alexb7396/Tesi_Magistrale/plots/A5256__Assembly.pdf

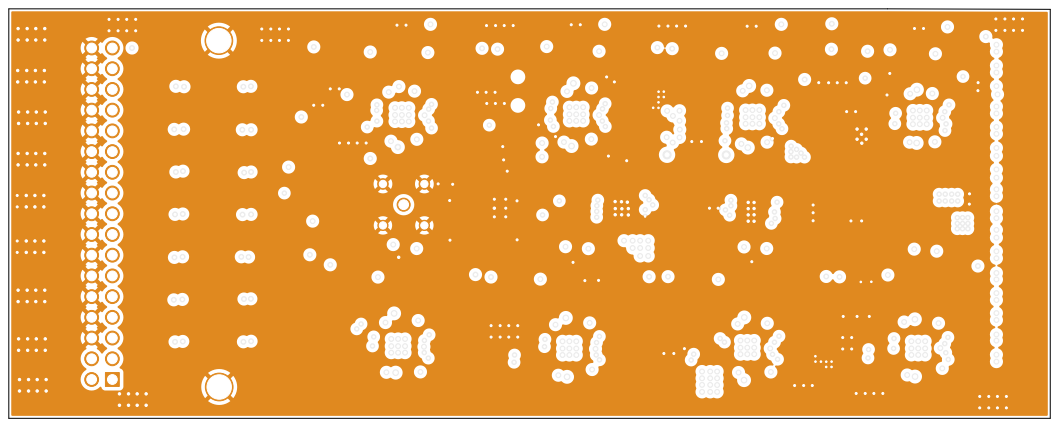
[picture p1: page 1]
D Date: KiCad; E.D.A. 8.0.7 Size: A4; Rev:; Board2Pdf:; GND -; Page

Id: 1/1 Title: File: A5256.kicad_pcb Sheet: GND
