alexb7396/Tesi_Magistrale/A5256.kicad_pcb

## KiCad design A5256.kicad_pcb (2024-12-22)

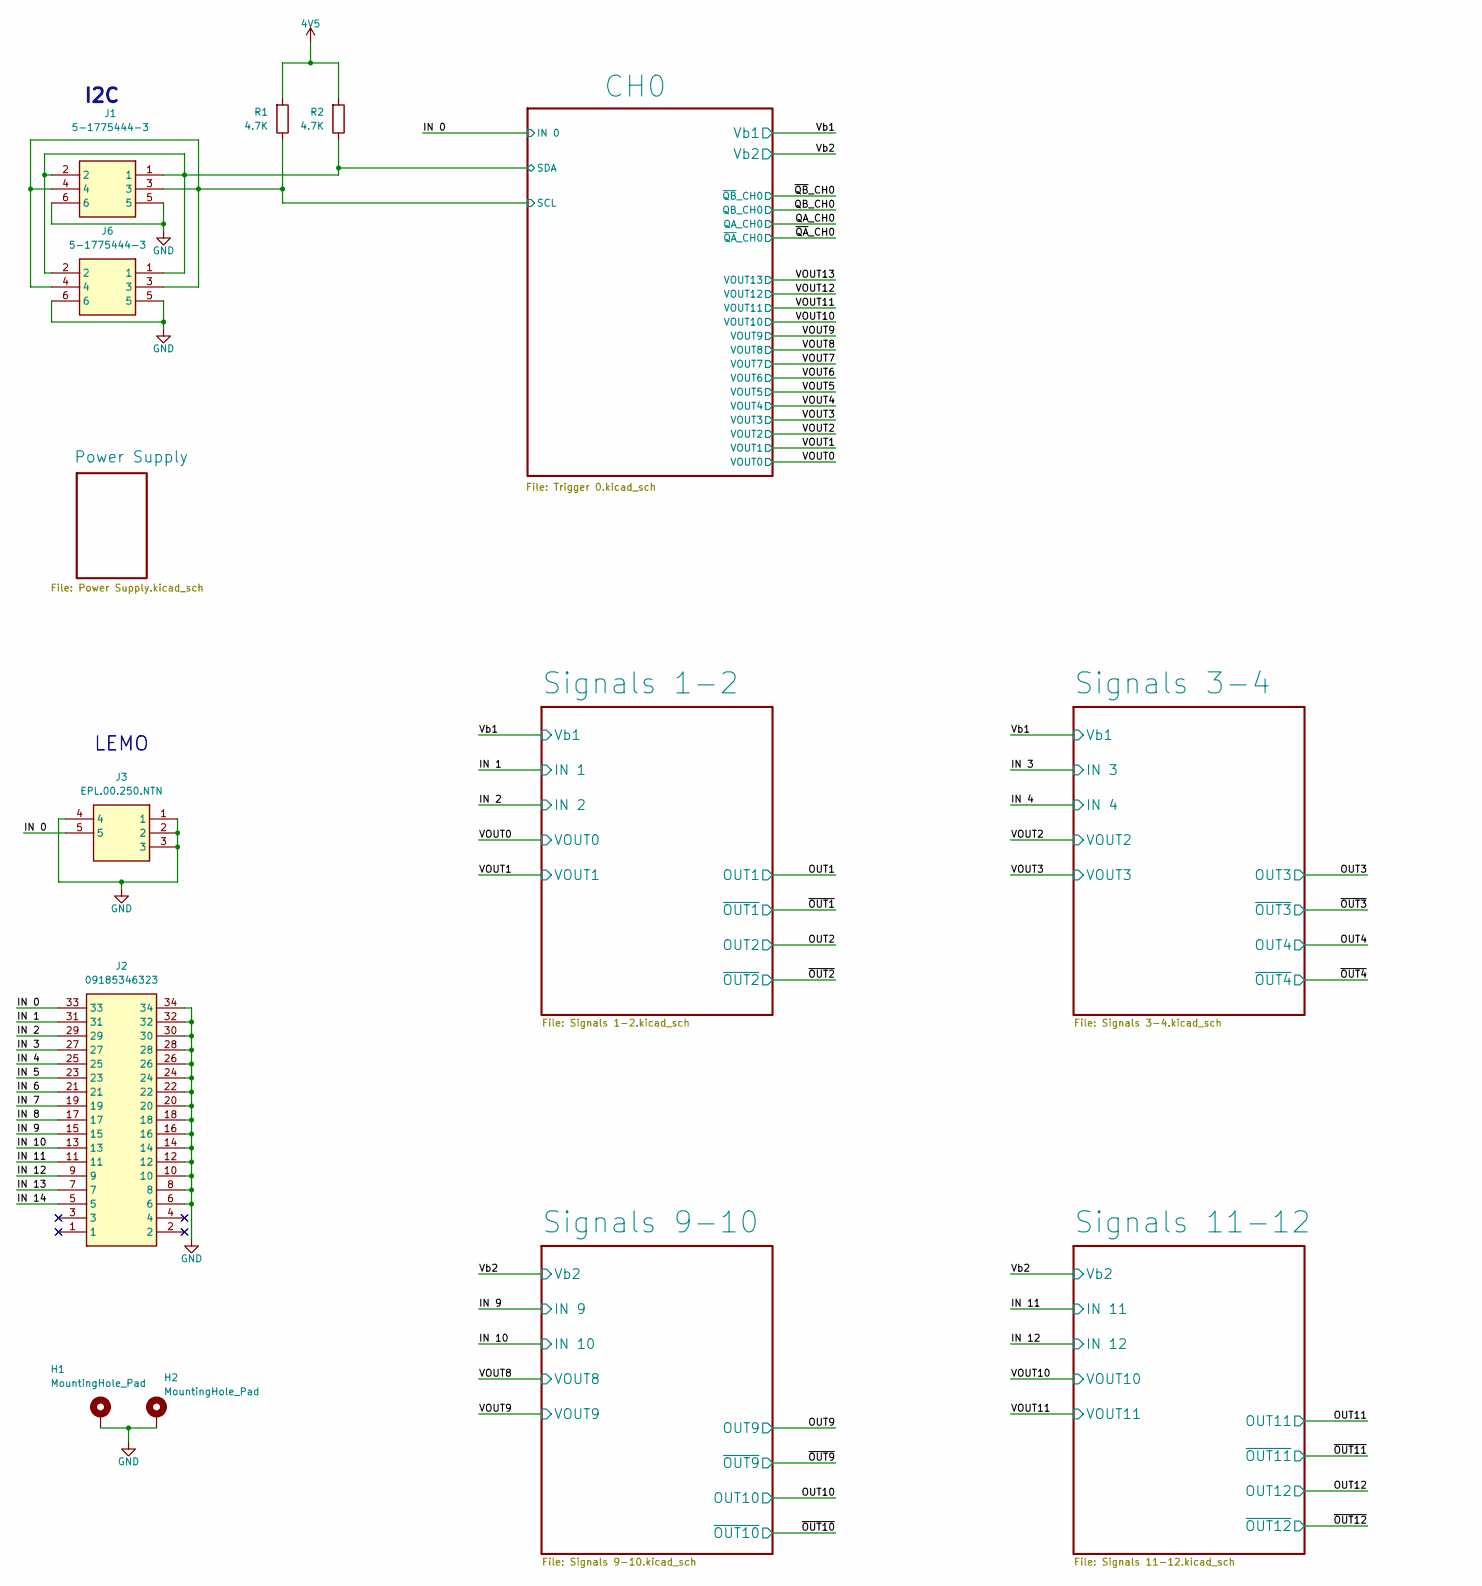
[picture p2: schematic A5256.kicad_sch, part in row 1, column 1]

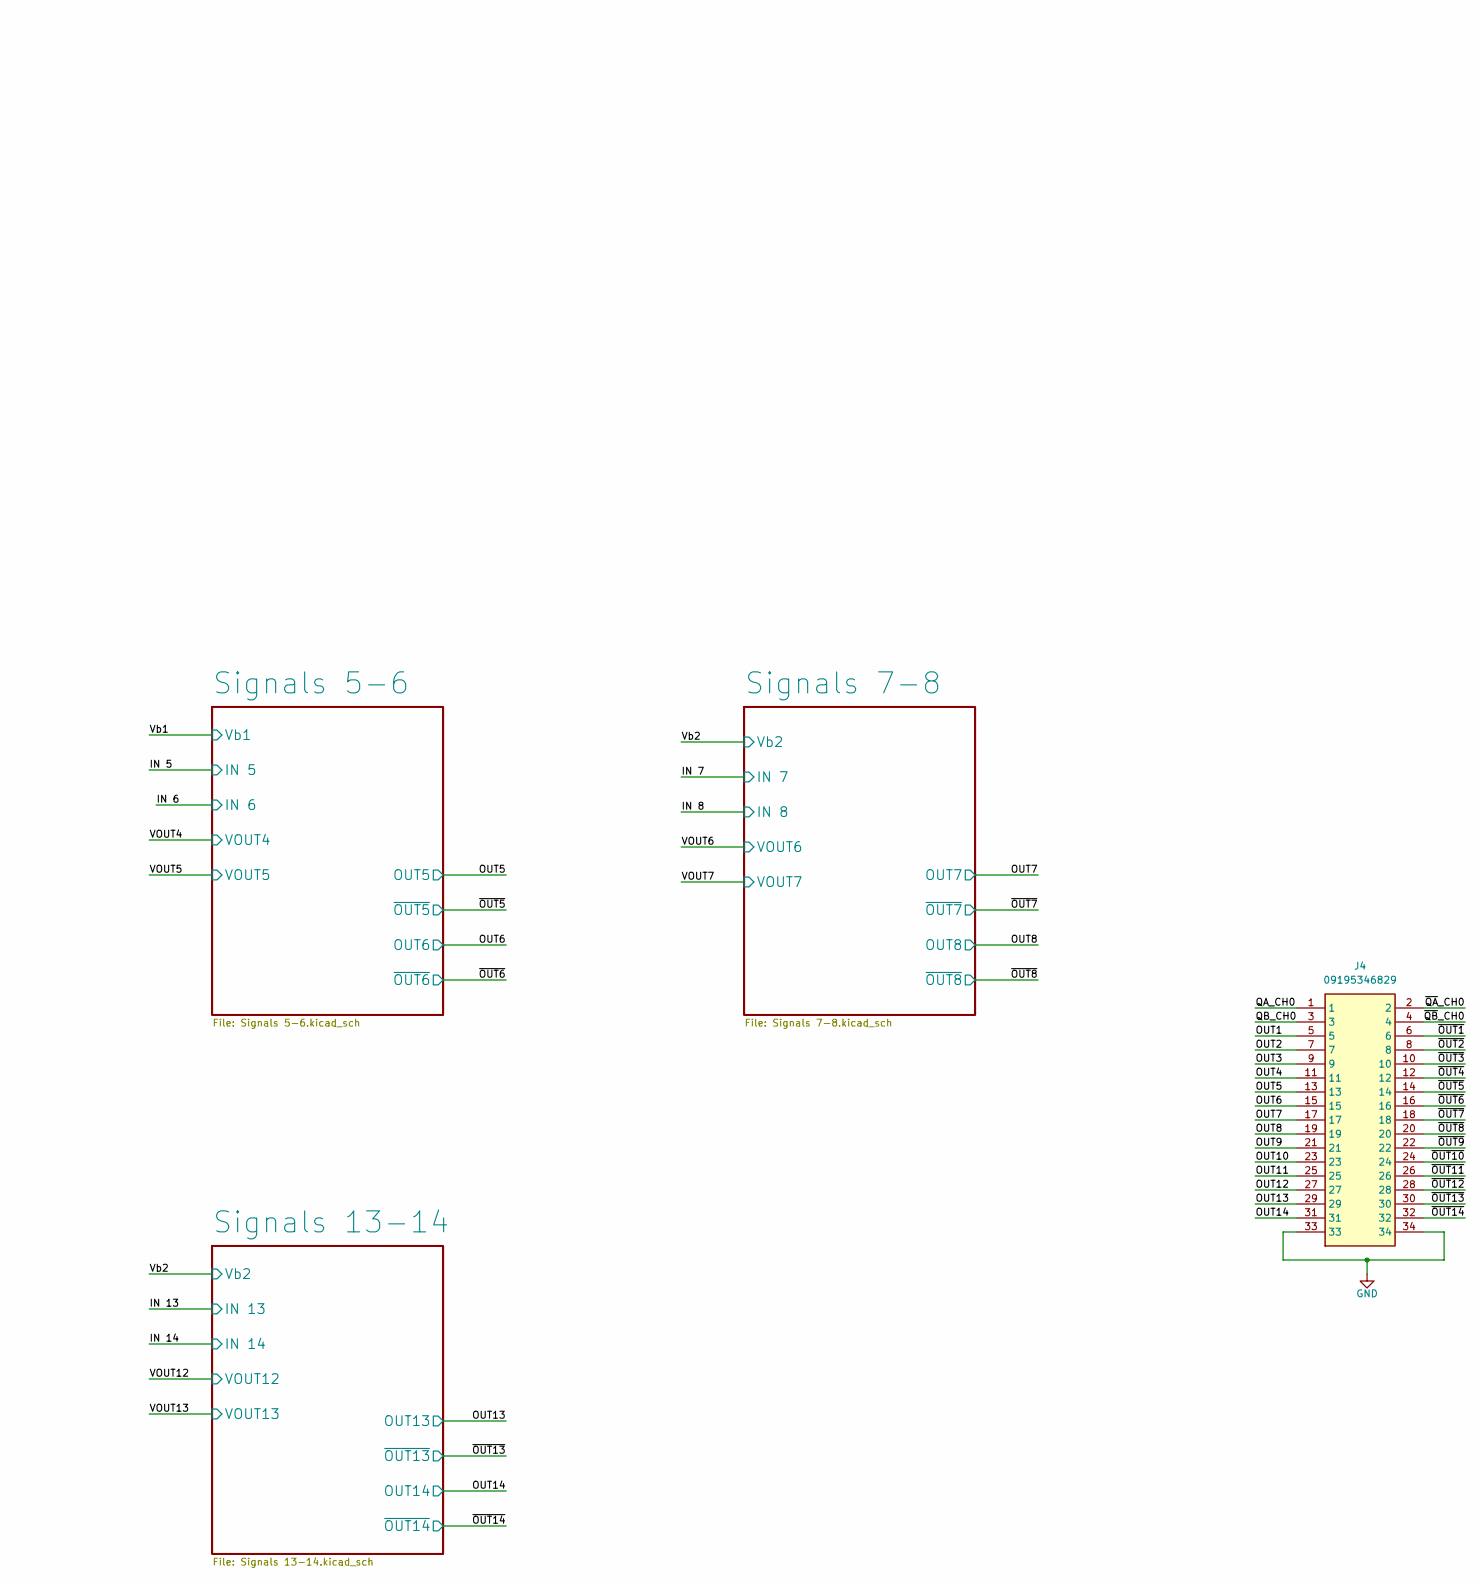
[picture p3: schematic A5256.kicad_sch, part in row 1, column 2]

Parts:
H1, H2: MountingHole_Pad; MountingHole_3mm_Pad_TopBottom
J1, J6: 5-1775444-3; 517754443; Mouser Part Number 571-5-1775444-3
J2: 09185346323; Mouser Part Number 617-09-18-534-6323
J3: EPL.00.250.NTN; LEMO-EPA.00.250.DTN; Mouser Part Number 736-EPL00250NTN
J4: 09195346829; 2x17 Connector; Mouser Part Number 617-09195346829
R1, R2: 4.7K; R_0603_1608Metric_Pad0.98x0.95mm_HandSolder

Connections:
4V5: R1.2, R2.2; also elsewhere on the board
/CH0/SCL: J1.3, J1.4, J6.3, J6.4, R1.1; also elsewhere on the board
/CH0/SDA: J1.1, J1.2, J6.1, J6.2, R2.1; also elsewhere on the board
/IN 0: J2.33, J3.5; also elsewhere on the board
/IN 1: J2.31; also elsewhere on the board
/IN 2: J2.29; also elsewhere on the board
/IN 3: J2.27; also elsewhere on the board
/IN 4: J2.25; also elsewhere on the board
/IN 5: J2.23; also elsewhere on the board
/IN 6: J2.21; also elsewhere on the board
/IN 7: J2.19; also elsewhere on the board
/IN 8: J2.17; also elsewhere on the board
/IN 9: J2.15; also elsewhere on the board
/IN 10: J2.13; also elsewhere on the board
/IN 11: J2.11; also elsewhere on the board
/IN 12: J2.9; also elsewhere on the board
/IN 13: J2.7; also elsewhere on the board
/IN 14: J2.5; also elsewhere on the board
/OUT1: J4.5; also elsewhere on the board
/OUT2: J4.7; also elsewhere on the board
/OUT3: J4.9; also elsewhere on the board
/OUT4: J4.11; also elsewhere on the board
/OUT5: J4.13; also elsewhere on the board
/OUT6: J4.15; also elsewhere on the board
/OUT7: J4.17; also elsewhere on the board
/OUT8: J4.19; also elsewhere on the board
/OUT9: J4.21; also elsewhere on the board
/OUT10: J4.23; also elsewhere on the board
/OUT11: J4.25; also elsewhere on the board
/OUT12: J4.27; also elsewhere on the board
/OUT13: J4.29; also elsewhere on the board
/OUT14: J4.31; also elsewhere on the board
/QA_CH0: J4.1; also elsewhere on the board
/QB_CH0: J4.3; also elsewhere on the board
/~OUT1: J4.6; also elsewhere on the board
/~OUT2: J4.8; also elsewhere on the board
/~OUT3: J4.10; also elsewhere on the board
/~OUT4: J4.12; also elsewhere on the board
/~OUT5: J4.14; also elsewhere on the board
/~OUT6: J4.16; also elsewhere on the board
/~OUT7: J4.18; also elsewhere on the board
/~OUT8: J4.20; also elsewhere on the board
/~OUT9: J4.22; also elsewhere on the board
/~OUT10: J4.24; also elsewhere on the board
/~OUT11: J4.26; also elsewhere on the board
/~OUT12: J4.28; also elsewhere on the board
/~OUT13: J4.30; also elsewhere on the board
/~OUT14: J4.32; also elsewhere on the board
/~QA_CH0: J4.2; also elsewhere on the board
/~QB_CH0: J4.4; also elsewhere on the board
GND: H1.1, H2.1, J1.5, J1.6, J2.6, J2.8, J2.10, J2.12, J2.14, J2.16, J2.18, J2.20, J2.22, J2.24, J2.26, J2.28, J2.30, J2.32, J2.34, J3.1, J3.2, J3.3, J3.4, J4.33, J4.34, J6.5, J6.6; also elsewhere on the board

Notes on the sheet:
I2C
LEMO

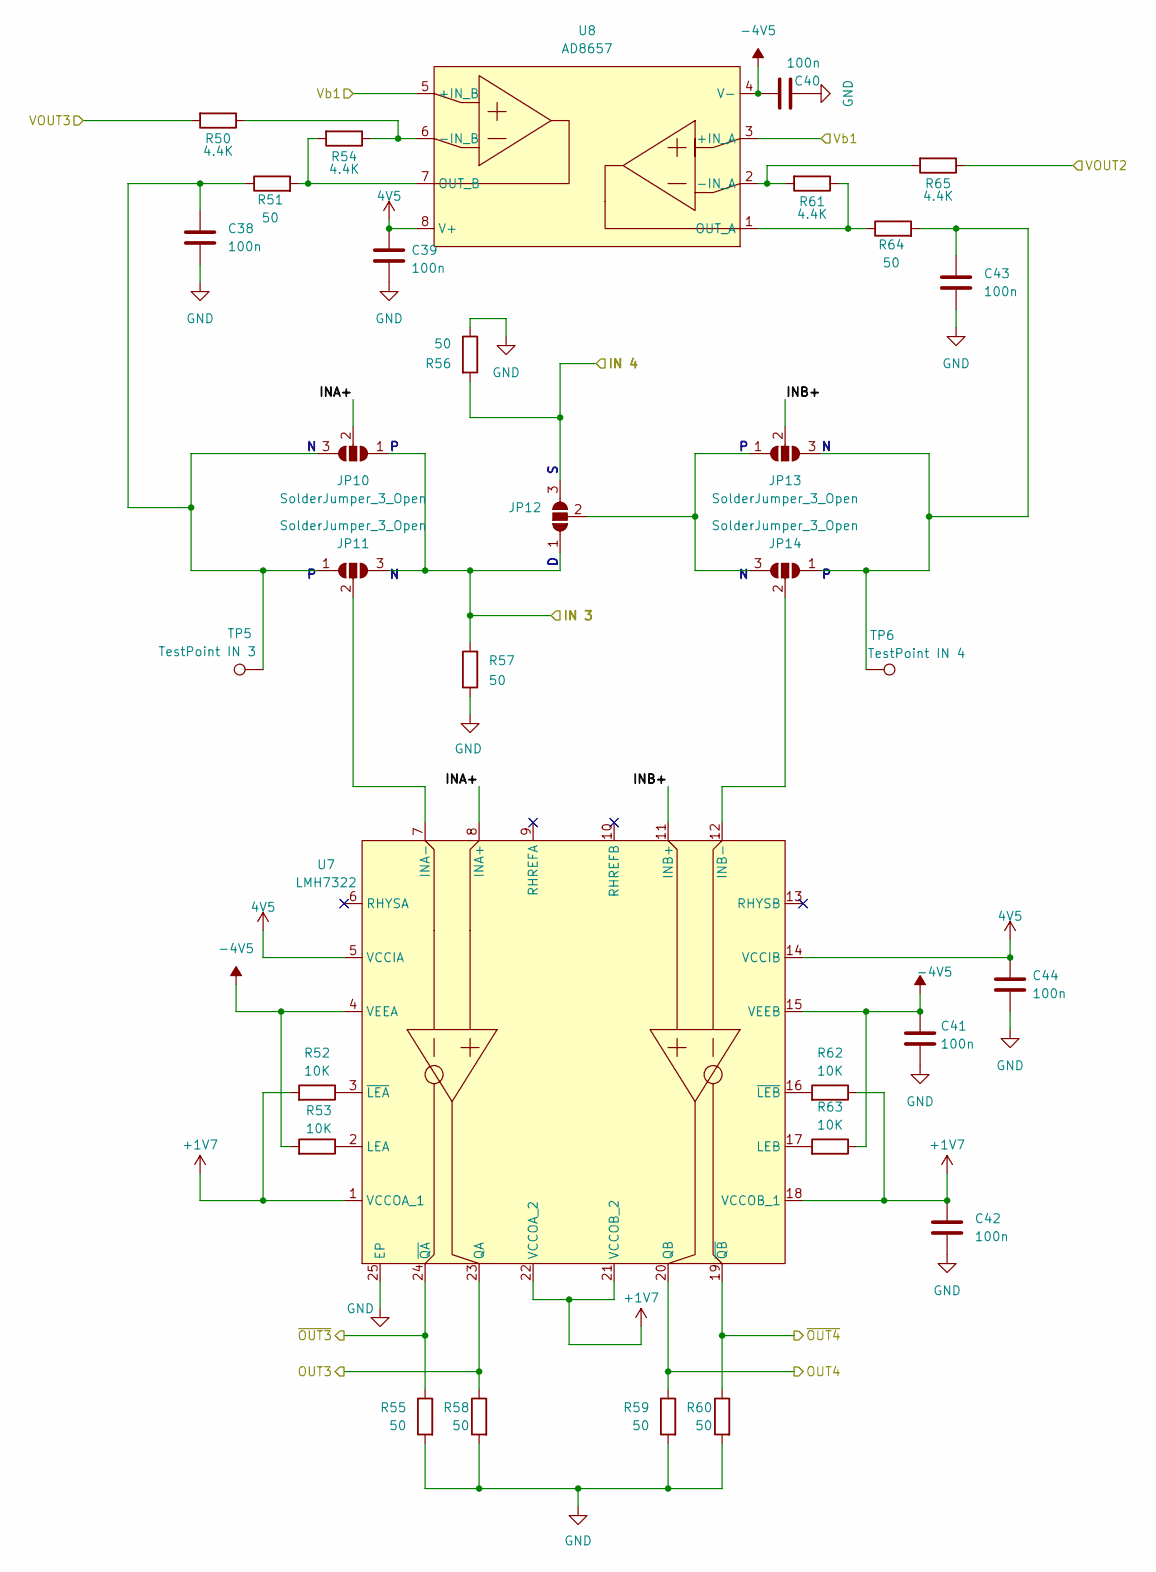
[picture p4: schematic Signals 3-4.kicad_sch]

Parts:
C38, C39, C40, C41, C42, C43, C44: 100n; C_0603_1608Metric_Pad1.08x0.95mm_HandSolder
JP10, JP11, JP12, JP13, JP14: SolderJumper_3_Open; SolderJumper-3_P1.3mm_Open_RoundedPad1.0x1.5mm_NumberLabels
R50, R54, R61, R65: 4.4K; R_0603_1608Metric_Pad0.98x0.95mm_HandSolder
R51, R55, R56, R57, R58, R59, R60, R64: 50; R_0603_1608Metric_Pad0.98x0.95mm_HandSolder
R52, R53, R62, R63: 10K; R_0603_1608Metric_Pad0.98x0.95mm_HandSolder
TP5: TestPoint IN 3; TestPoint_Pad_D1.0mm
TP6: TestPoint IN 4; TestPoint_Pad_D1.0mm
U7: LMH7322; QFN50P400X400X80-25N
U8: AD8657; SOP65P490X110-8N

Connections:
4V5: C39.1, C44.1, U7.5 (VCCIA), U7.14 (VCCIB), U8.8 (V+); also elsewhere on the board
+1V7: C42.1, R52.2, R62.1, U7.1 (VCCOA_1), U7.18 (VCCOB_1), U7.21 (VCCOB_2), U7.22 (VCCOA_2); also elsewhere on the board
-4V5: C40.1, C41.1, R53.2, R63.1, U7.4 (VEEA), U7.15 (VEEB), U8.4 (V-); also elsewhere on the board
/IN 3: JP10.1 (A), JP11.3 (B), JP12.1 (A), R57.2; also elsewhere on the board
/IN 4: JP12.3 (B), R56.2; also elsewhere on the board
/OUT3: R58.1, U7.23 (QA); also elsewhere on the board
/OUT4: R59.1, U7.20 (QB); also elsewhere on the board
/Signals 3-4/INA+: JP10.2 (C), U7.8 (INA+)
/Signals 3-4/INB+: JP13.2 (C), U7.11 (INB+)
/VOUT2: R65.1; also elsewhere on the board
/VOUT3: R50.2; also elsewhere on the board
/Vb1: U8.3 (+IN_A), U8.5 (+IN_B); also elsewhere on the board
/~OUT3: R55.1, U7.24 (~QA); also elsewhere on the board
/~OUT4: R60.1, U7.19 (~QB); also elsewhere on the board
GND: C38.2, C39.2, C40.2, C41.2, C42.2, C43.2, C44.2, R55.2, R56.1, R57.1, R58.2, R59.2, R60.2, U7.25 (EP); also elsewhere on the board
unnamed: C38.1, JP10.3 (B), JP11.1 (A), R51.1, TP5.1
unnamed: JP11.2 (C), U7.7 (INA-)
unnamed: JP12.2 (C), JP13.1 (A), JP14.3 (B)
unnamed: C43.1, JP13.3 (B), JP14.1 (A), R64.2, TP6.1
unnamed: JP14.2 (C), U7.12 (INB-)
unnamed: R53.1, U7.2 (LEA)
unnamed: R63.2, U7.17 (LEB)
unnamed: R52.1, U7.3 (~LEA)
unnamed: R62.2, U7.16 (~LEB)
unnamed: R61.2, R65.2, U8.2 (-IN_A)
unnamed: R50.1, R54.1, U8.6 (-IN_B)
unnamed: R61.1, R64.1, U8.1 (OUT_A)
unnamed: R51.2, R54.2, U8.7 (OUT_B)

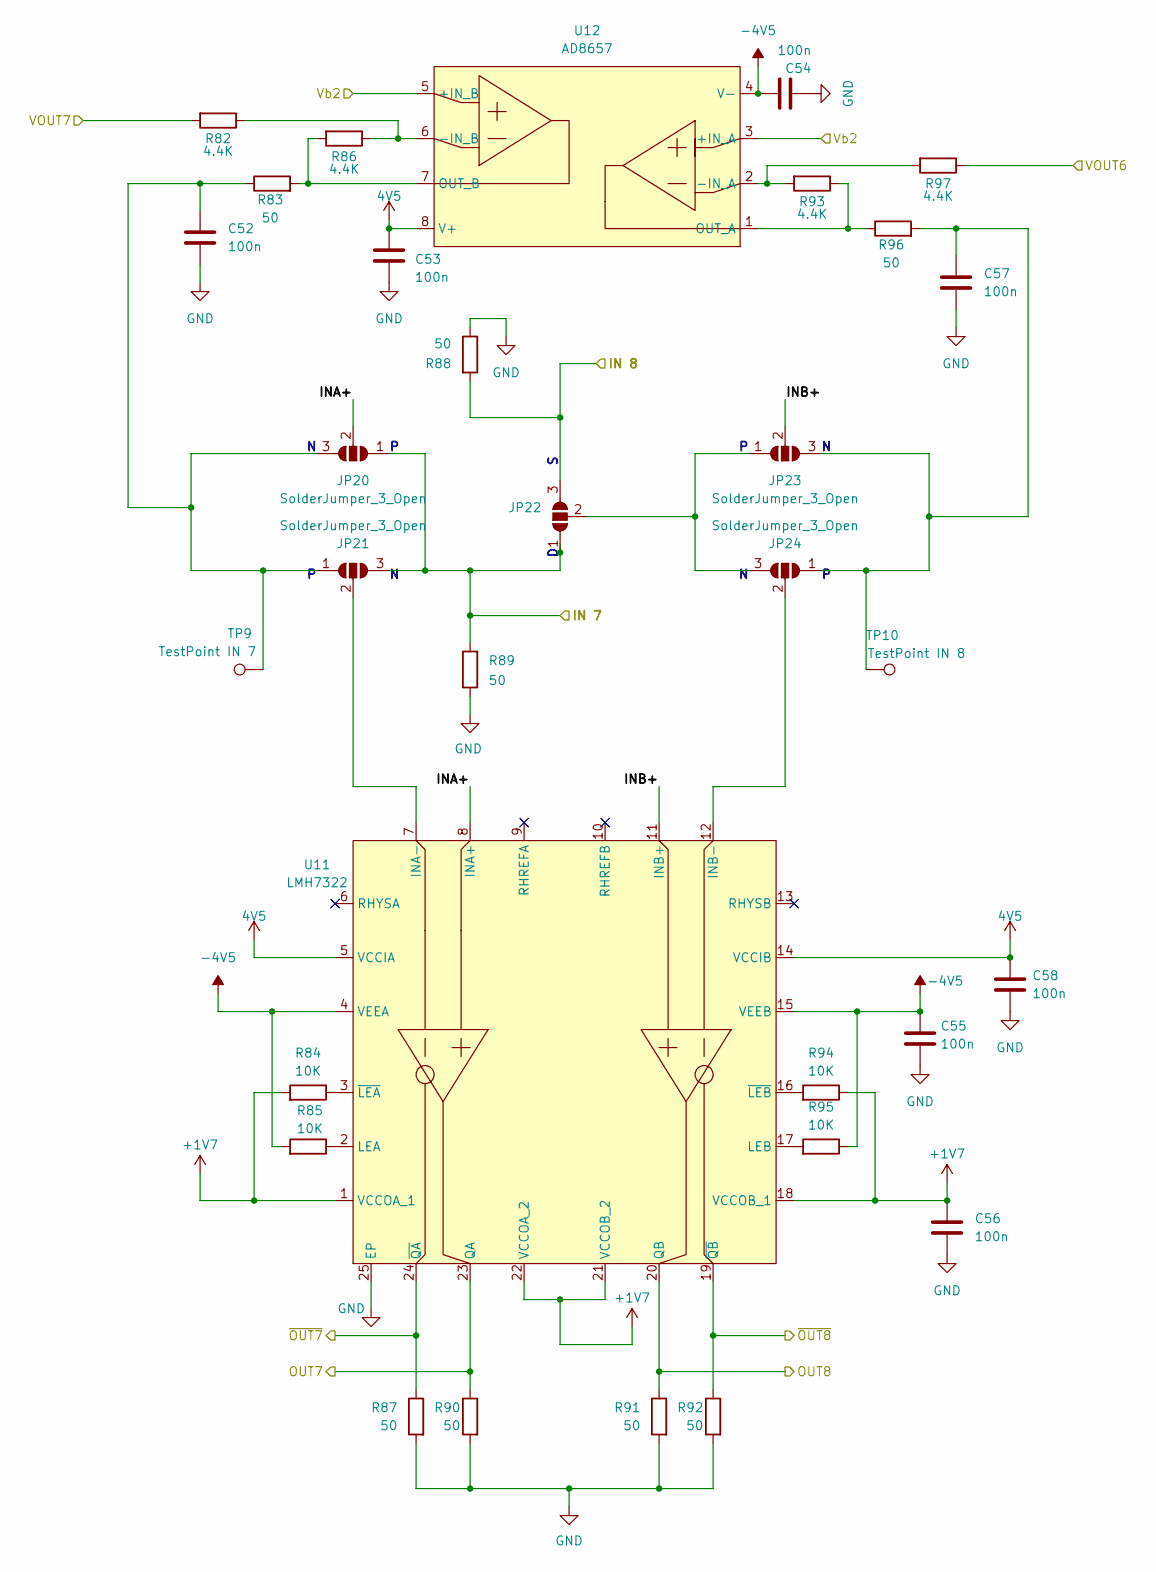
[picture p5: schematic Signals 7-8.kicad_sch]

Parts:
C52, C53, C54, C55, C56, C57, C58: 100n; C_0603_1608Metric_Pad1.08x0.95mm_HandSolder
JP20, JP21, JP22, JP23, JP24: SolderJumper_3_Open; SolderJumper-3_P1.3mm_Open_RoundedPad1.0x1.5mm_NumberLabels
R82, R86, R93, R97: 4.4K; R_0603_1608Metric_Pad0.98x0.95mm_HandSolder
R83, R87, R88, R89, R90, R91, R92, R96: 50; R_0603_1608Metric_Pad0.98x0.95mm_HandSolder
R84, R85, R94, R95: 10K; R_0603_1608Metric_Pad0.98x0.95mm_HandSolder
TP9: TestPoint IN 7; TestPoint_Pad_D1.0mm
TP10: TestPoint IN 8; TestPoint_Pad_D1.0mm
U11: LMH7322; QFN50P400X400X80-25N
U12: AD8657; SOP65P490X110-8N

Connections:
4V5: C53.1, C58.1, U11.5 (VCCIA), U11.14 (VCCIB), U12.8 (V+); also elsewhere on the board
+1V7: C56.1, R84.2, R94.1, U11.1 (VCCOA_1), U11.18 (VCCOB_1), U11.21 (VCCOB_2), U11.22 (VCCOA_2); also elsewhere on the board
-4V5: C54.1, C55.1, R85.2, R95.1, U11.4 (VEEA), U11.15 (VEEB), U12.4 (V-); also elsewhere on the board
/IN 7: JP20.1 (A), JP21.3 (B), JP22.1 (A), R89.2; also elsewhere on the board
/IN 8: JP22.3 (B), R88.2; also elsewhere on the board
/OUT7: R90.1, U11.23 (QA); also elsewhere on the board
/OUT8: R91.1, U11.20 (QB); also elsewhere on the board
/Signals 7-8/INA+: JP20.2 (C), U11.8 (INA+)
/Signals 7-8/INB+: JP23.2 (C), U11.11 (INB+)
/VOUT6: R97.1; also elsewhere on the board
/VOUT7: R82.2; also elsewhere on the board
/Vb2: U12.3 (+IN_A), U12.5 (+IN_B); also elsewhere on the board
/~OUT7: R87.1, U11.24 (~QA); also elsewhere on the board
/~OUT8: R92.1, U11.19 (~QB); also elsewhere on the board
GND: C52.2, C53.2, C54.2, C55.2, C56.2, C57.2, C58.2, R87.2, R88.1, R89.1, R90.2, R91.2, R92.2, U11.25 (EP); also elsewhere on the board
unnamed: C52.1, JP20.3 (B), JP21.1 (A), R83.1, TP9.1
unnamed: JP21.2 (C), U11.7 (INA-)
unnamed: JP22.2 (C), JP23.1 (A), JP24.3 (B)
unnamed: C57.1, JP23.3 (B), JP24.1 (A), R96.2, TP10.1
unnamed: JP24.2 (C), U11.12 (INB-)
unnamed: R85.1, U11.2 (LEA)
unnamed: R95.2, U11.17 (LEB)
unnamed: R84.1, U11.3 (~LEA)
unnamed: R94.2, U11.16 (~LEB)
unnamed: R93.2, R97.2, U12.2 (-IN_A)
unnamed: R82.1, R86.1, U12.6 (-IN_B)
unnamed: R93.1, R96.1, U12.1 (OUT_A)
unnamed: R83.2, R86.2, U12.7 (OUT_B)

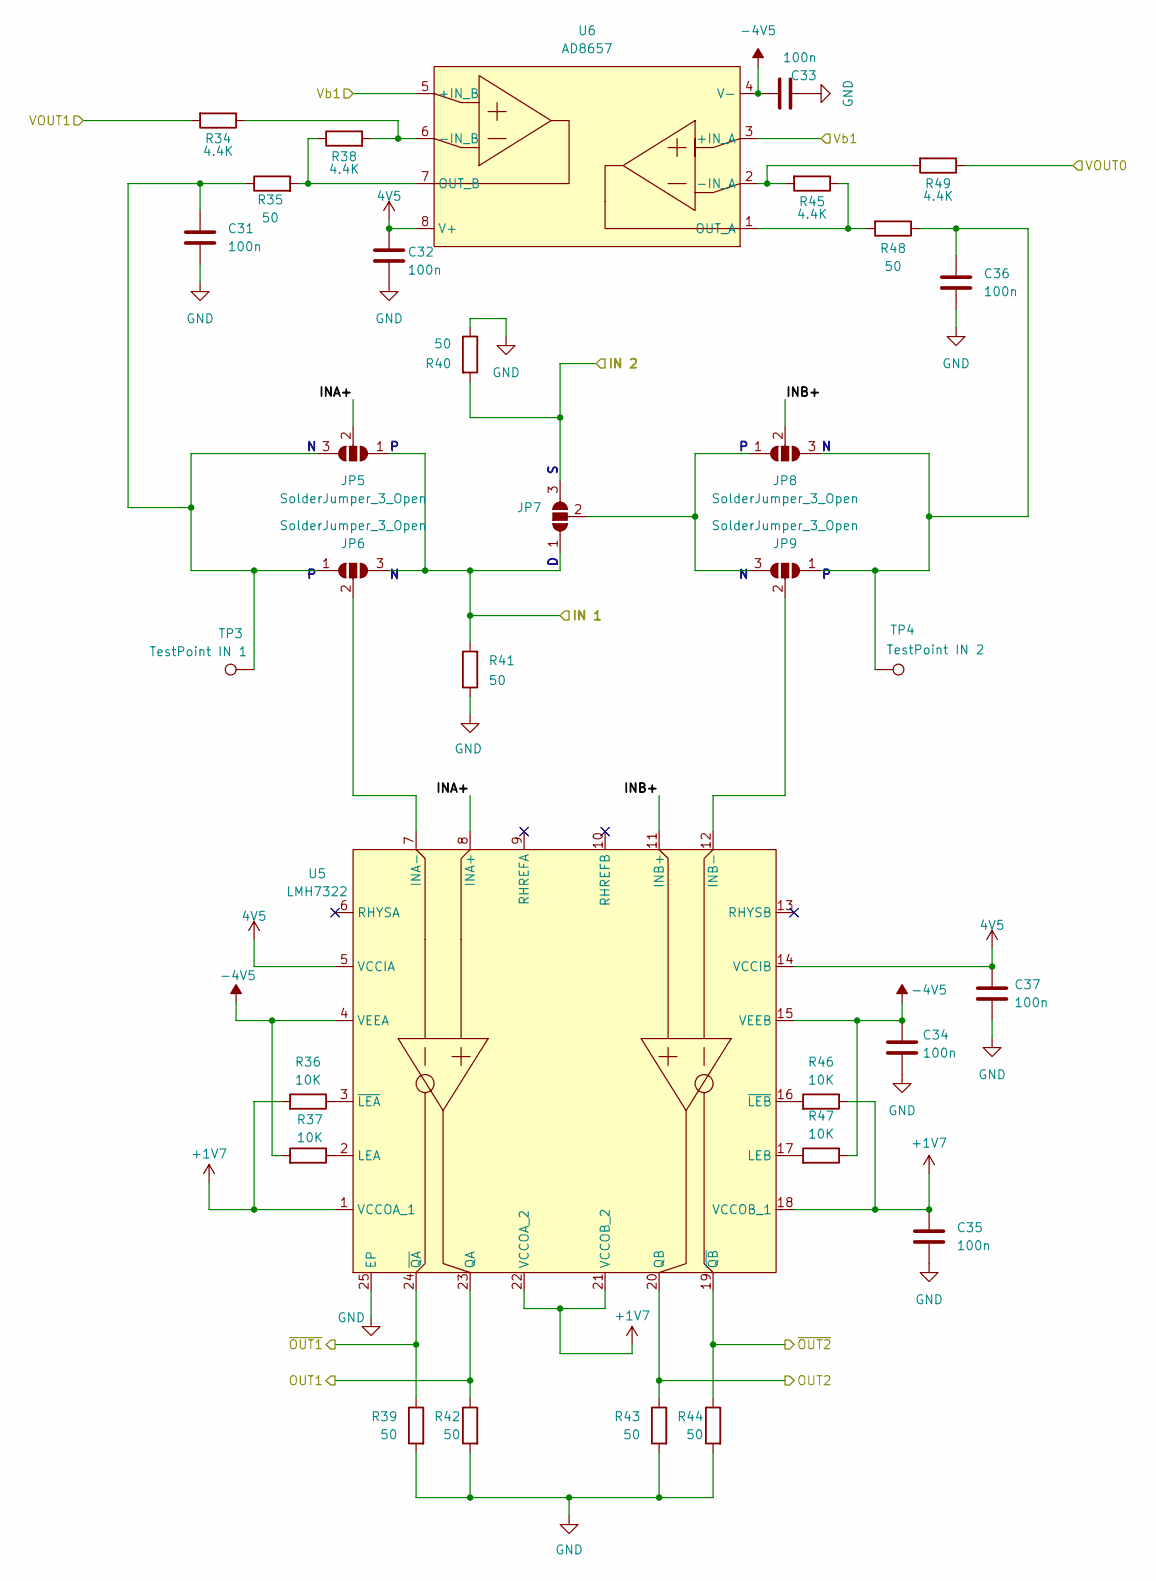
[picture p6: schematic Signals 1-2.kicad_sch]

Parts:
C31, C32, C33, C34, C35, C36, C37: 100n; C_0603_1608Metric_Pad1.08x0.95mm_HandSolder
JP5, JP6, JP7, JP8, JP9: SolderJumper_3_Open; SolderJumper-3_P1.3mm_Open_RoundedPad1.0x1.5mm_NumberLabels
R34, R38, R45, R49: 4.4K; R_0603_1608Metric_Pad0.98x0.95mm_HandSolder
R35, R39, R40, R41, R42, R43, R44, R48: 50; R_0603_1608Metric_Pad0.98x0.95mm_HandSolder
R36, R37, R46, R47: 10K; R_0603_1608Metric_Pad0.98x0.95mm_HandSolder
TP3: TestPoint IN 1; TestPoint_Pad_D1.0mm
TP4: TestPoint IN 2; TestPoint_Pad_D1.0mm
U5: LMH7322; QFN50P400X400X80-25N
U6: AD8657; SOP65P490X110-8N

Connections:
4V5: C32.1, C37.1, U5.5 (VCCIA), U5.14 (VCCIB), U6.8 (V+); also elsewhere on the board
+1V7: C35.1, R36.2, R46.1, U5.1 (VCCOA_1), U5.18 (VCCOB_1), U5.21 (VCCOB_2), U5.22 (VCCOA_2); also elsewhere on the board
-4V5: C33.1, C34.1, R37.2, R47.1, U5.4 (VEEA), U5.15 (VEEB), U6.4 (V-); also elsewhere on the board
/IN 1: JP5.1 (A), JP6.3 (B), JP7.1 (A), R41.2; also elsewhere on the board
/IN 2: JP7.3 (B), R40.2; also elsewhere on the board
/OUT1: R42.1, U5.23 (QA); also elsewhere on the board
/OUT2: R43.1, U5.20 (QB); also elsewhere on the board
/Signals 1-2/INA+: JP5.2 (C), U5.8 (INA+)
/Signals 1-2/INB+: JP8.2 (C), U5.11 (INB+)
/VOUT0: R49.1; also elsewhere on the board
/VOUT1: R34.2; also elsewhere on the board
/Vb1: U6.3 (+IN_A), U6.5 (+IN_B); also elsewhere on the board
/~OUT1: R39.1, U5.24 (~QA); also elsewhere on the board
/~OUT2: R44.1, U5.19 (~QB); also elsewhere on the board
GND: C31.2, C32.2, C33.2, C34.2, C35.2, C36.2, C37.2, R39.2, R40.1, R41.1, R42.2, R43.2, R44.2, U5.25 (EP); also elsewhere on the board
unnamed: C31.1, JP5.3 (B), JP6.1 (A), R35.1, TP3.1
unnamed: JP6.2 (C), U5.7 (INA-)
unnamed: JP7.2 (C), JP8.1 (A), JP9.3 (B)
unnamed: C36.1, JP8.3 (B), JP9.1 (A), R48.1, TP4.1
unnamed: JP9.2 (C), U5.12 (INB-)
unnamed: R37.1, U5.2 (LEA)
unnamed: R47.2, U5.17 (LEB)
unnamed: R36.1, U5.3 (~LEA)
unnamed: R46.2, U5.16 (~LEB)
unnamed: R45.2, R49.2, U6.2 (-IN_A)
unnamed: R34.1, R38.2, U6.6 (-IN_B)
unnamed: R45.1, R48.2, U6.1 (OUT_A)
unnamed: R35.2, R38.1, U6.7 (OUT_B)

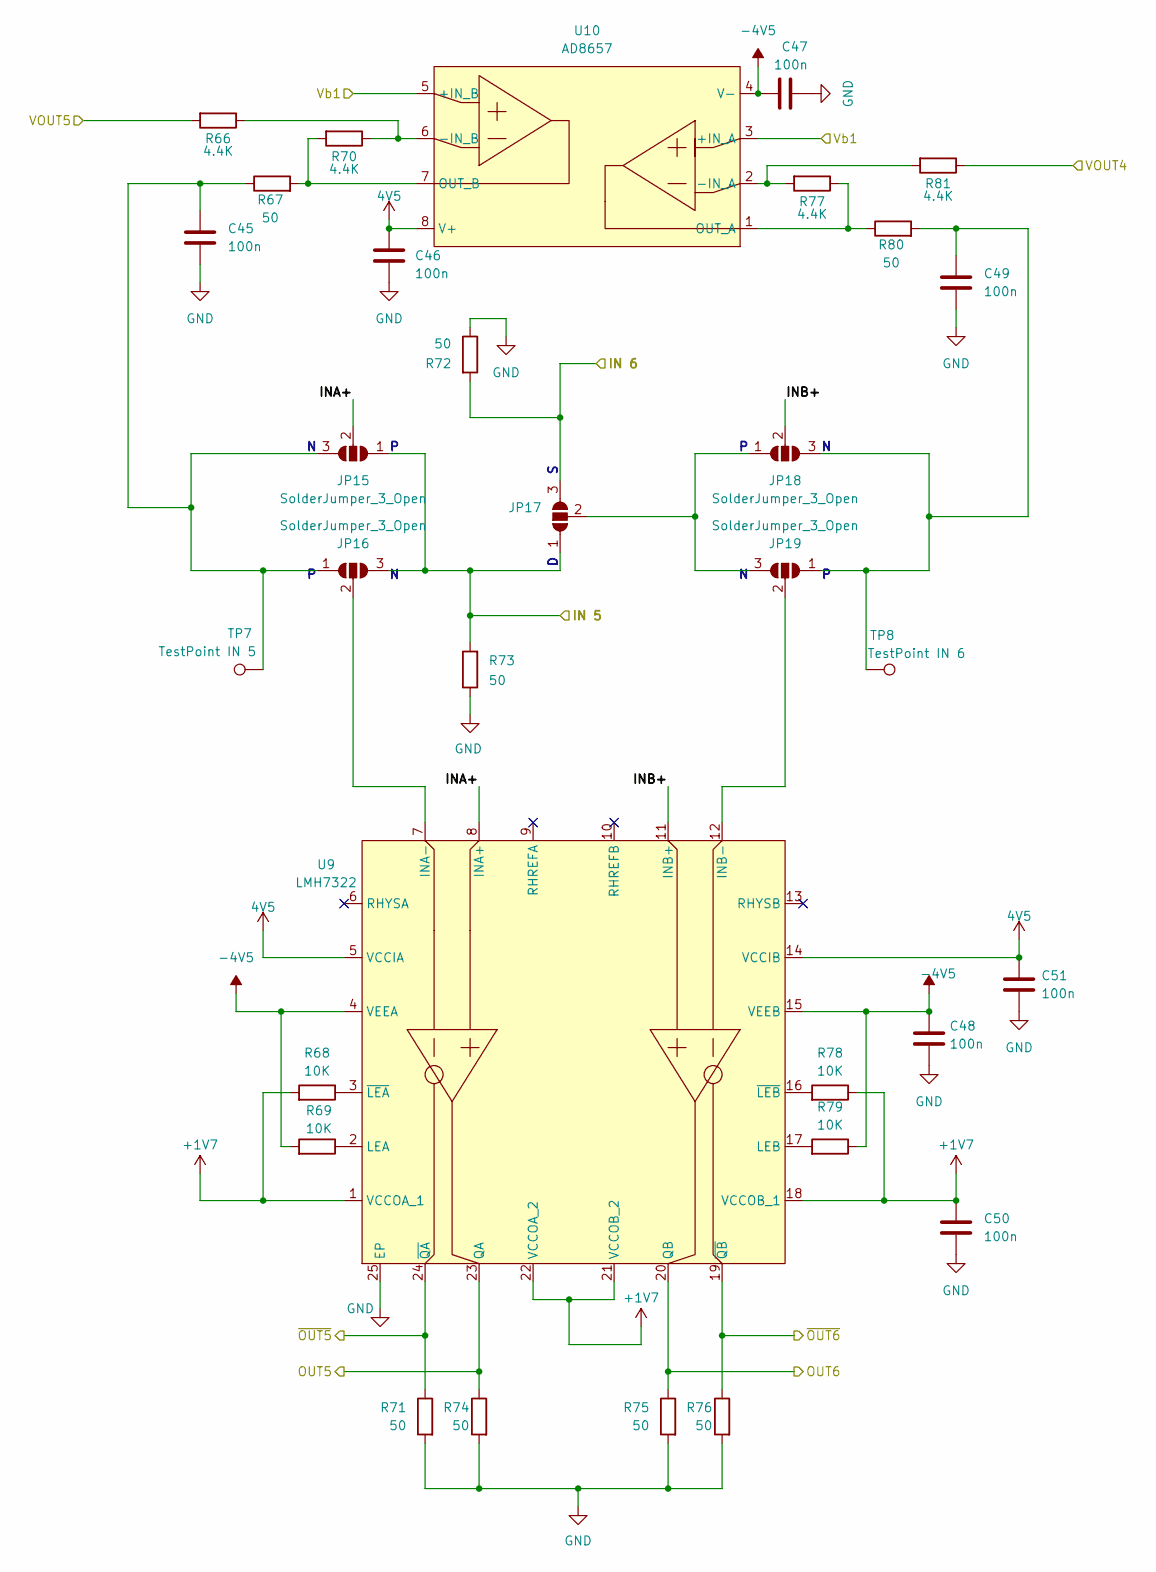
[picture p7: schematic Signals 5-6.kicad_sch]

Parts:
C45, C46, C47, C48, C49, C50, C51: 100n; C_0603_1608Metric_Pad1.08x0.95mm_HandSolder
JP15, JP16, JP17, JP18, JP19: SolderJumper_3_Open; SolderJumper-3_P1.3mm_Open_RoundedPad1.0x1.5mm_NumberLabels
R66, R70, R77, R81: 4.4K; R_0603_1608Metric_Pad0.98x0.95mm_HandSolder
R67, R71, R72, R73, R74, R75, R76, R80: 50; R_0603_1608Metric_Pad0.98x0.95mm_HandSolder
R68, R69, R78, R79: 10K; R_0603_1608Metric_Pad0.98x0.95mm_HandSolder
TP7: TestPoint IN 5; TestPoint_Pad_D1.0mm
TP8: TestPoint IN 6; TestPoint_Pad_D1.0mm
U9: LMH7322; QFN50P400X400X80-25N
U10: AD8657; SOP65P490X110-8N

Connections:
4V5: C46.1, C51.1, U9.5 (VCCIA), U9.14 (VCCIB), U10.8 (V+); also elsewhere on the board
+1V7: C50.1, R68.2, R78.1, U9.1 (VCCOA_1), U9.18 (VCCOB_1), U9.21 (VCCOB_2), U9.22 (VCCOA_2); also elsewhere on the board
-4V5: C47.1, C48.1, R69.2, R79.1, U9.4 (VEEA), U9.15 (VEEB), U10.4 (V-); also elsewhere on the board
/IN 5: JP15.1 (A), JP16.3 (B), JP17.1 (A), R73.2; also elsewhere on the board
/IN 6: JP17.3 (B), R72.2; also elsewhere on the board
/OUT5: R74.1, U9.23 (QA); also elsewhere on the board
/OUT6: R75.1, U9.20 (QB); also elsewhere on the board
/Signals 5-6/INA+: JP15.2 (C), U9.8 (INA+)
/Signals 5-6/INB+: JP18.2 (C), U9.11 (INB+)
/VOUT4: R81.1; also elsewhere on the board
/VOUT5: R66.2; also elsewhere on the board
/Vb1: U10.3 (+IN_A), U10.5 (+IN_B); also elsewhere on the board
/~OUT5: R71.1, U9.24 (~QA); also elsewhere on the board
/~OUT6: R76.1, U9.19 (~QB); also elsewhere on the board
GND: C45.2, C46.2, C47.2, C48.2, C49.2, C50.2, C51.2, R71.2, R72.1, R73.1, R74.2, R75.2, R76.2, U9.25 (EP); also elsewhere on the board
unnamed: C45.1, JP15.3 (B), JP16.1 (A), R67.1, TP7.1
unnamed: JP16.2 (C), U9.7 (INA-)
unnamed: JP17.2 (C), JP18.1 (A), JP19.3 (B)
unnamed: C49.1, JP18.3 (B), JP19.1 (A), R80.2, TP8.1
unnamed: JP19.2 (C), U9.12 (INB-)
unnamed: R69.1, U9.2 (LEA)
unnamed: R79.2, U9.17 (LEB)
unnamed: R68.1, U9.3 (~LEA)
unnamed: R78.2, U9.16 (~LEB)
unnamed: R77.2, R81.2, U10.2 (-IN_A)
unnamed: R66.1, R70.1, U10.6 (-IN_B)
unnamed: R77.1, R80.1, U10.1 (OUT_A)
unnamed: R67.2, R70.2, U10.7 (OUT_B)

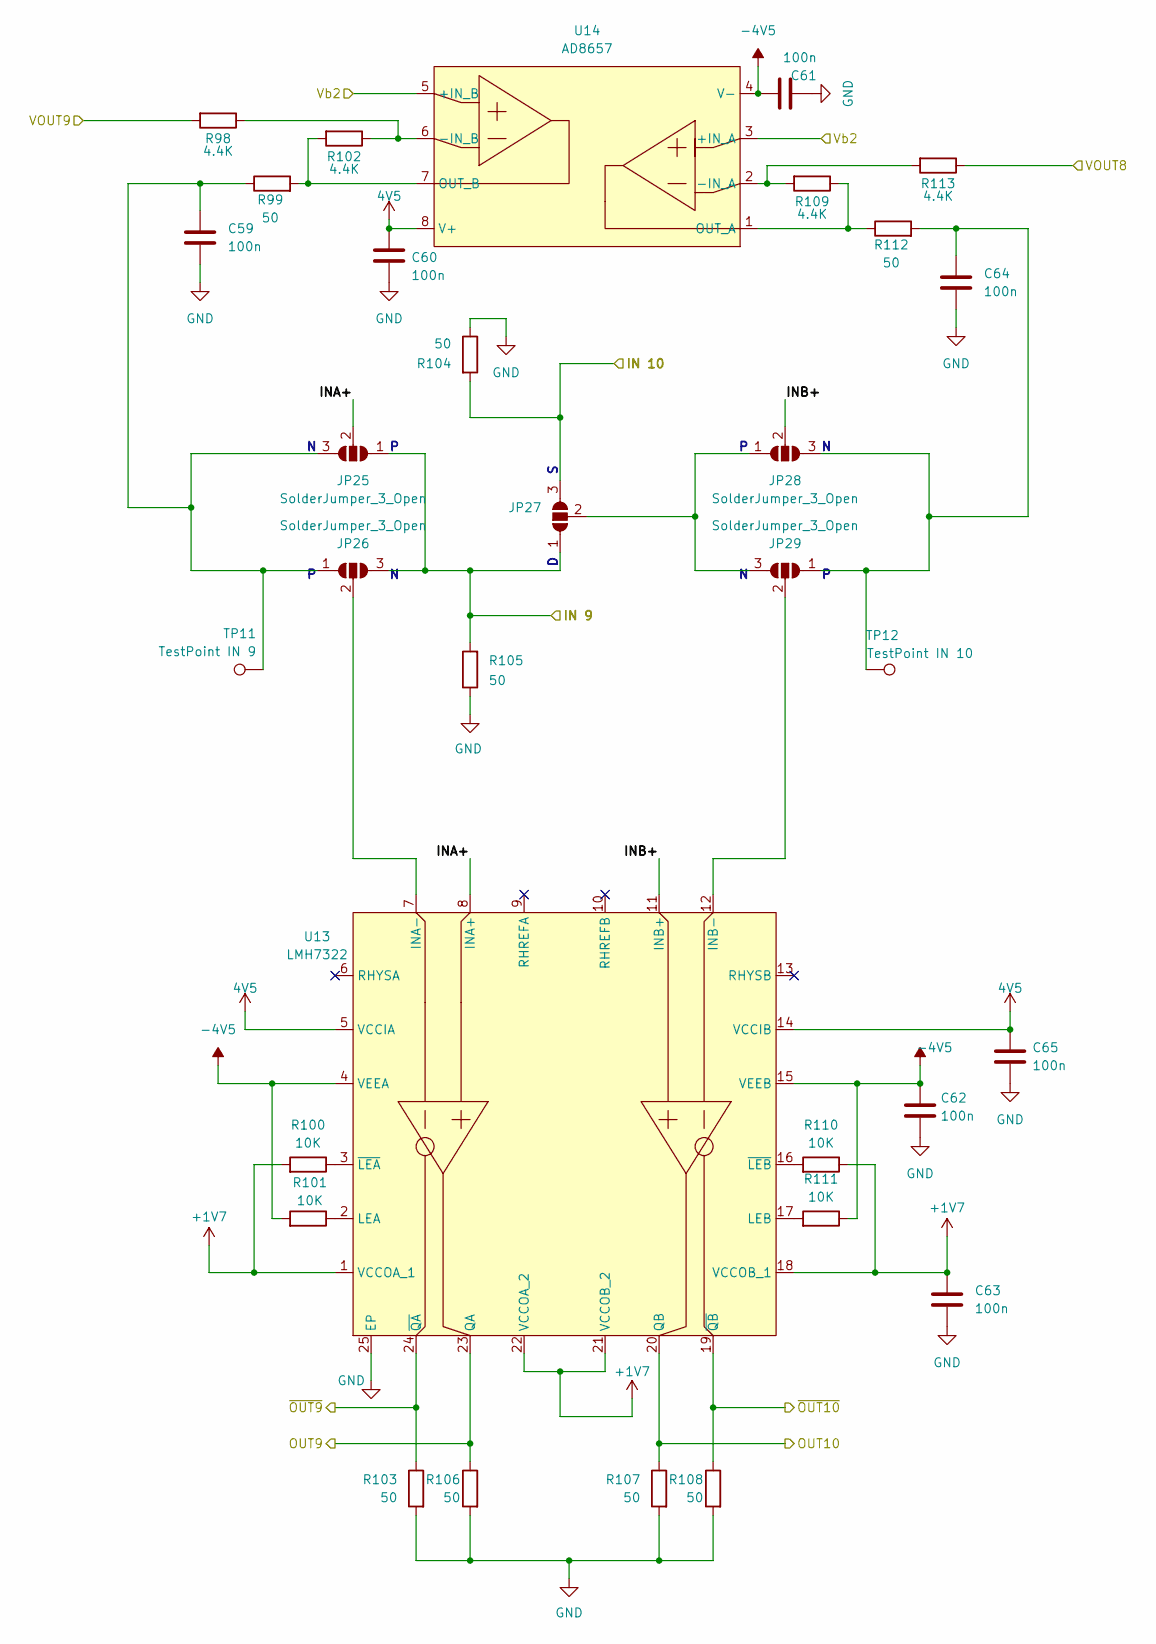
[picture p8: schematic Signals 9-10.kicad_sch]

Parts:
C59, C60, C61, C62, C63, C64, C65: 100n; C_0603_1608Metric_Pad1.08x0.95mm_HandSolder
JP25, JP26, JP27, JP28, JP29: SolderJumper_3_Open; SolderJumper-3_P1.3mm_Open_RoundedPad1.0x1.5mm_NumberLabels
R98, R102, R109, R113: 4.4K; R_0603_1608Metric_Pad0.98x0.95mm_HandSolder
R99, R103, R104, R105, R106, R107, R108, R112: 50; R_0603_1608Metric_Pad0.98x0.95mm_HandSolder
R100, R101, R110, R111: 10K; R_0603_1608Metric_Pad0.98x0.95mm_HandSolder
TP11: TestPoint IN 9; TestPoint_Pad_D1.0mm
TP12: TestPoint IN 10; TestPoint_Pad_D1.0mm
U13: LMH7322; QFN50P400X400X80-25N
U14: AD8657; SOP65P490X110-8N

Connections:
4V5: C60.1, C65.1, U13.5 (VCCIA), U13.14 (VCCIB), U14.8 (V+); also elsewhere on the board
+1V7: C63.1, R100.2, R110.1, U13.1 (VCCOA_1), U13.18 (VCCOB_1), U13.21 (VCCOB_2), U13.22 (VCCOA_2); also elsewhere on the board
-4V5: C61.1, C62.1, R101.2, R111.1, U13.4 (VEEA), U13.15 (VEEB), U14.4 (V-); also elsewhere on the board
/IN 9: JP25.1 (A), JP26.3 (B), JP27.1 (A), R105.2; also elsewhere on the board
/IN 10: JP27.3 (B), R104.2; also elsewhere on the board
/OUT9: R106.1, U13.23 (QA); also elsewhere on the board
/OUT10: R107.1, U13.20 (QB); also elsewhere on the board
/Signals 9-10/INA+: JP25.2 (C), U13.8 (INA+)
/Signals 9-10/INB+: JP28.2 (C), U13.11 (INB+)
/VOUT8: R113.1; also elsewhere on the board
/VOUT9: R98.2; also elsewhere on the board
/Vb2: U14.3 (+IN_A), U14.5 (+IN_B); also elsewhere on the board
/~OUT9: R103.1, U13.24 (~QA); also elsewhere on the board
/~OUT10: R108.1, U13.19 (~QB); also elsewhere on the board
GND: C59.2, C60.2, C61.2, C62.2, C63.2, C64.2, C65.2, R103.2, R104.1, R105.1, R106.2, R107.2, R108.2, U13.25 (EP); also elsewhere on the board
unnamed: C59.1, JP25.3 (B), JP26.1 (A), R99.1, TP11.1
unnamed: JP26.2 (C), U13.7 (INA-)
unnamed: JP27.2 (C), JP28.1 (A), JP29.3 (B)
unnamed: C64.1, JP28.3 (B), JP29.1 (A), R112.2, TP12.1
unnamed: JP29.2 (C), U13.12 (INB-)
unnamed: R101.1, U13.2 (LEA)
unnamed: R111.2, U13.17 (LEB)
unnamed: R100.1, U13.3 (~LEA)
unnamed: R110.2, U13.16 (~LEB)
unnamed: R109.2, R113.2, U14.2 (-IN_A)
unnamed: R98.1, R102.1, U14.6 (-IN_B)
unnamed: R109.1, R112.1, U14.1 (OUT_A)
unnamed: R99.2, R102.2, U14.7 (OUT_B)
