alexb7396/Tesi_Magistrale/A5256.kicad_pcb

## KiCad design A5256.kicad_pcb (continued)

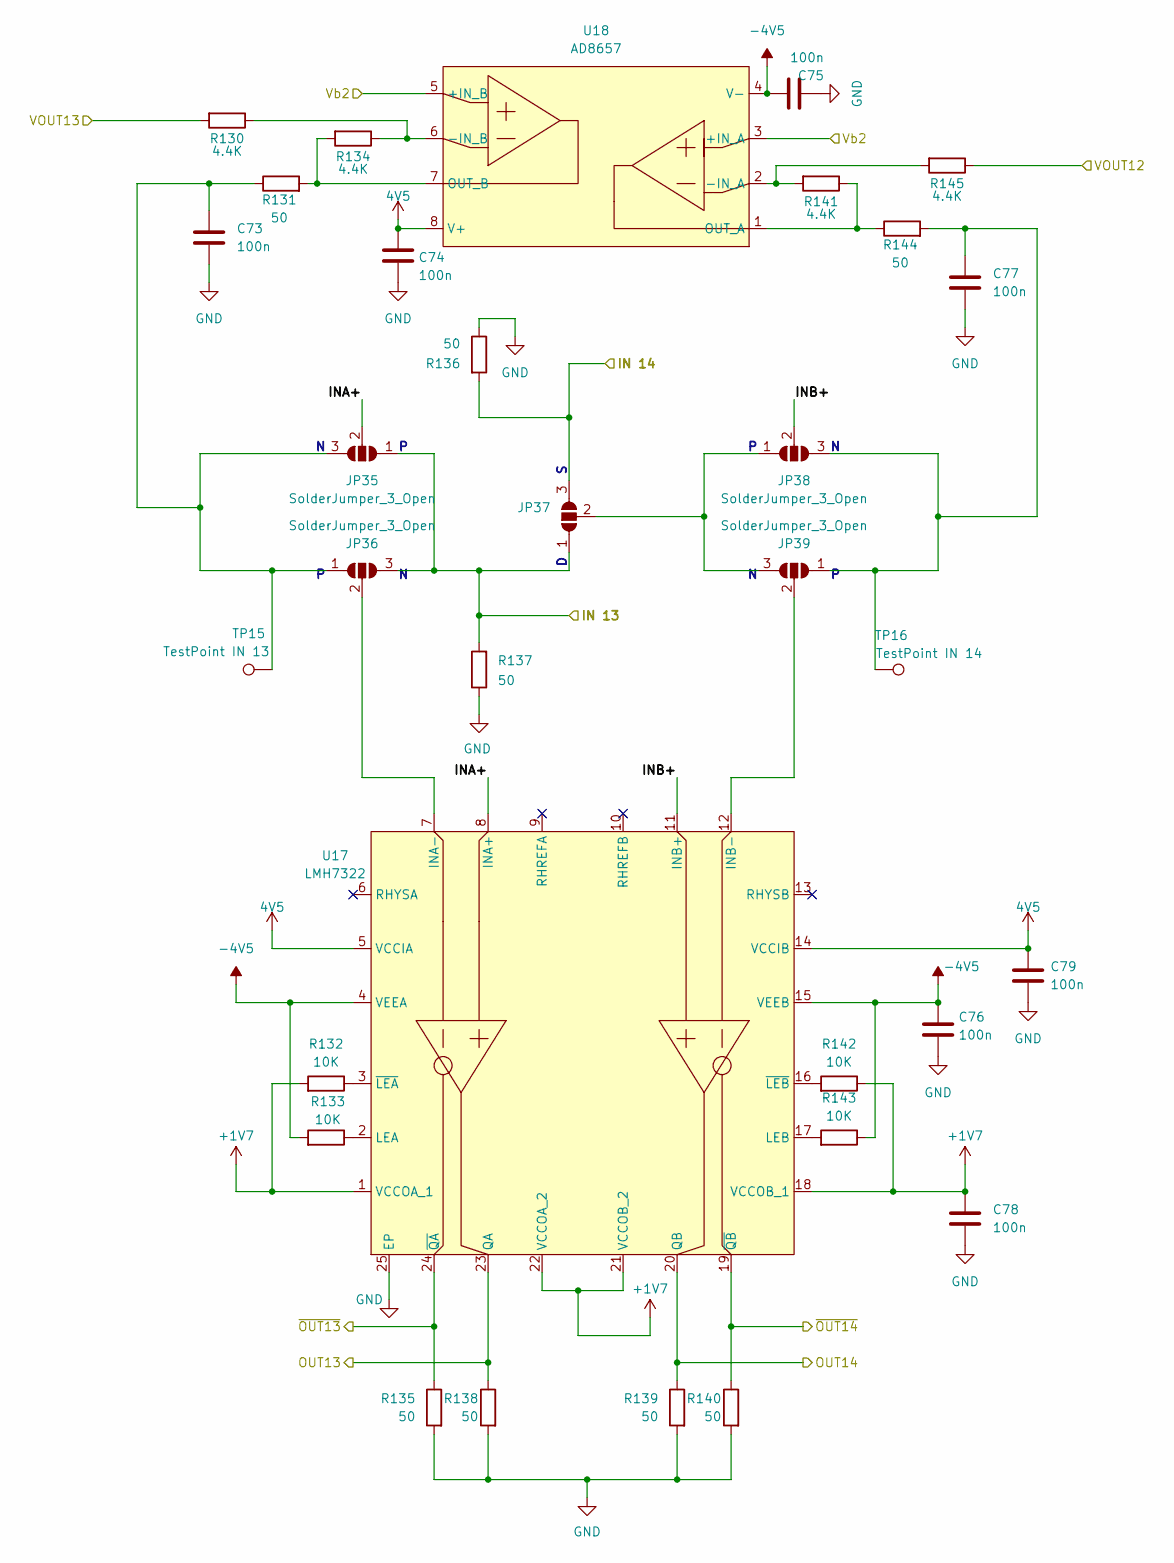
[picture p9: schematic Signals 13-14.kicad_sch]

Parts:
C73, C74, C75, C76, C77, C78, C79: 100n; C_0603_1608Metric_Pad1.08x0.95mm_HandSolder
JP35, JP36, JP37, JP38, JP39: SolderJumper_3_Open; SolderJumper-3_P1.3mm_Open_RoundedPad1.0x1.5mm_NumberLabels
R130, R134, R141, R145: 4.4K; R_0603_1608Metric_Pad0.98x0.95mm_HandSolder
R131, R135, R136, R137, R138, R139, R140, R144: 50; R_0603_1608Metric_Pad0.98x0.95mm_HandSolder
R132, R133, R142, R143: 10K; R_0603_1608Metric_Pad0.98x0.95mm_HandSolder
TP15: TestPoint IN 13; TestPoint_Pad_D1.0mm
TP16: TestPoint IN 14; TestPoint_Pad_D1.0mm
U17: LMH7322; QFN50P400X400X80-25N
U18: AD8657; SOP65P490X110-8N

Connections:
4V5: C74.1, C79.1, U17.5 (VCCIA), U17.14 (VCCIB), U18.8 (V+); also elsewhere on the board
+1V7: C78.1, R132.2, R142.1, U17.1 (VCCOA_1), U17.18 (VCCOB_1), U17.21 (VCCOB_2), U17.22 (VCCOA_2); also elsewhere on the board
-4V5: C75.1, C76.1, R133.2, R143.1, U17.4 (VEEA), U17.15 (VEEB), U18.4 (V-); also elsewhere on the board
/IN 13: JP35.1 (A), JP36.3 (B), JP37.1 (A), R137.2; also elsewhere on the board
/IN 14: JP37.3 (B), R136.2; also elsewhere on the board
/OUT13: R138.1, U17.23 (QA); also elsewhere on the board
/OUT14: R139.1, U17.20 (QB); also elsewhere on the board
/Signals 13-14/INA+: JP35.2 (C), U17.8 (INA+)
/Signals 13-14/INB+: JP38.2 (C), U17.11 (INB+)
/VOUT12: R145.1; also elsewhere on the board
/VOUT13: R130.2; also elsewhere on the board
/Vb2: U18.3 (+IN_A), U18.5 (+IN_B); also elsewhere on the board
/~OUT13: R135.1, U17.24 (~QA); also elsewhere on the board
/~OUT14: R140.1, U17.19 (~QB); also elsewhere on the board
GND: C73.2, C74.2, C75.2, C76.2, C77.2, C78.2, C79.2, R135.2, R136.1, R137.1, R138.2, R139.2, R140.2, U17.25 (EP); also elsewhere on the board
unnamed: C73.1, JP35.3 (B), JP36.1 (A), R131.1, TP15.1
unnamed: JP36.2 (C), U17.7 (INA-)
unnamed: JP37.2 (C), JP38.1 (A), JP39.3 (B)
unnamed: C77.1, JP38.3 (B), JP39.1 (A), R144.2, TP16.1
unnamed: JP39.2 (C), U17.12 (INB-)
unnamed: R133.1, U17.2 (LEA)
unnamed: R143.2, U17.17 (LEB)
unnamed: R132.1, U17.3 (~LEA)
unnamed: R142.2, U17.16 (~LEB)
unnamed: R141.2, R145.2, U18.2 (-IN_A)
unnamed: R130.1, R134.1, U18.6 (-IN_B)
unnamed: R141.1, R144.1, U18.1 (OUT_A)
unnamed: R131.2, R134.2, U18.7 (OUT_B)

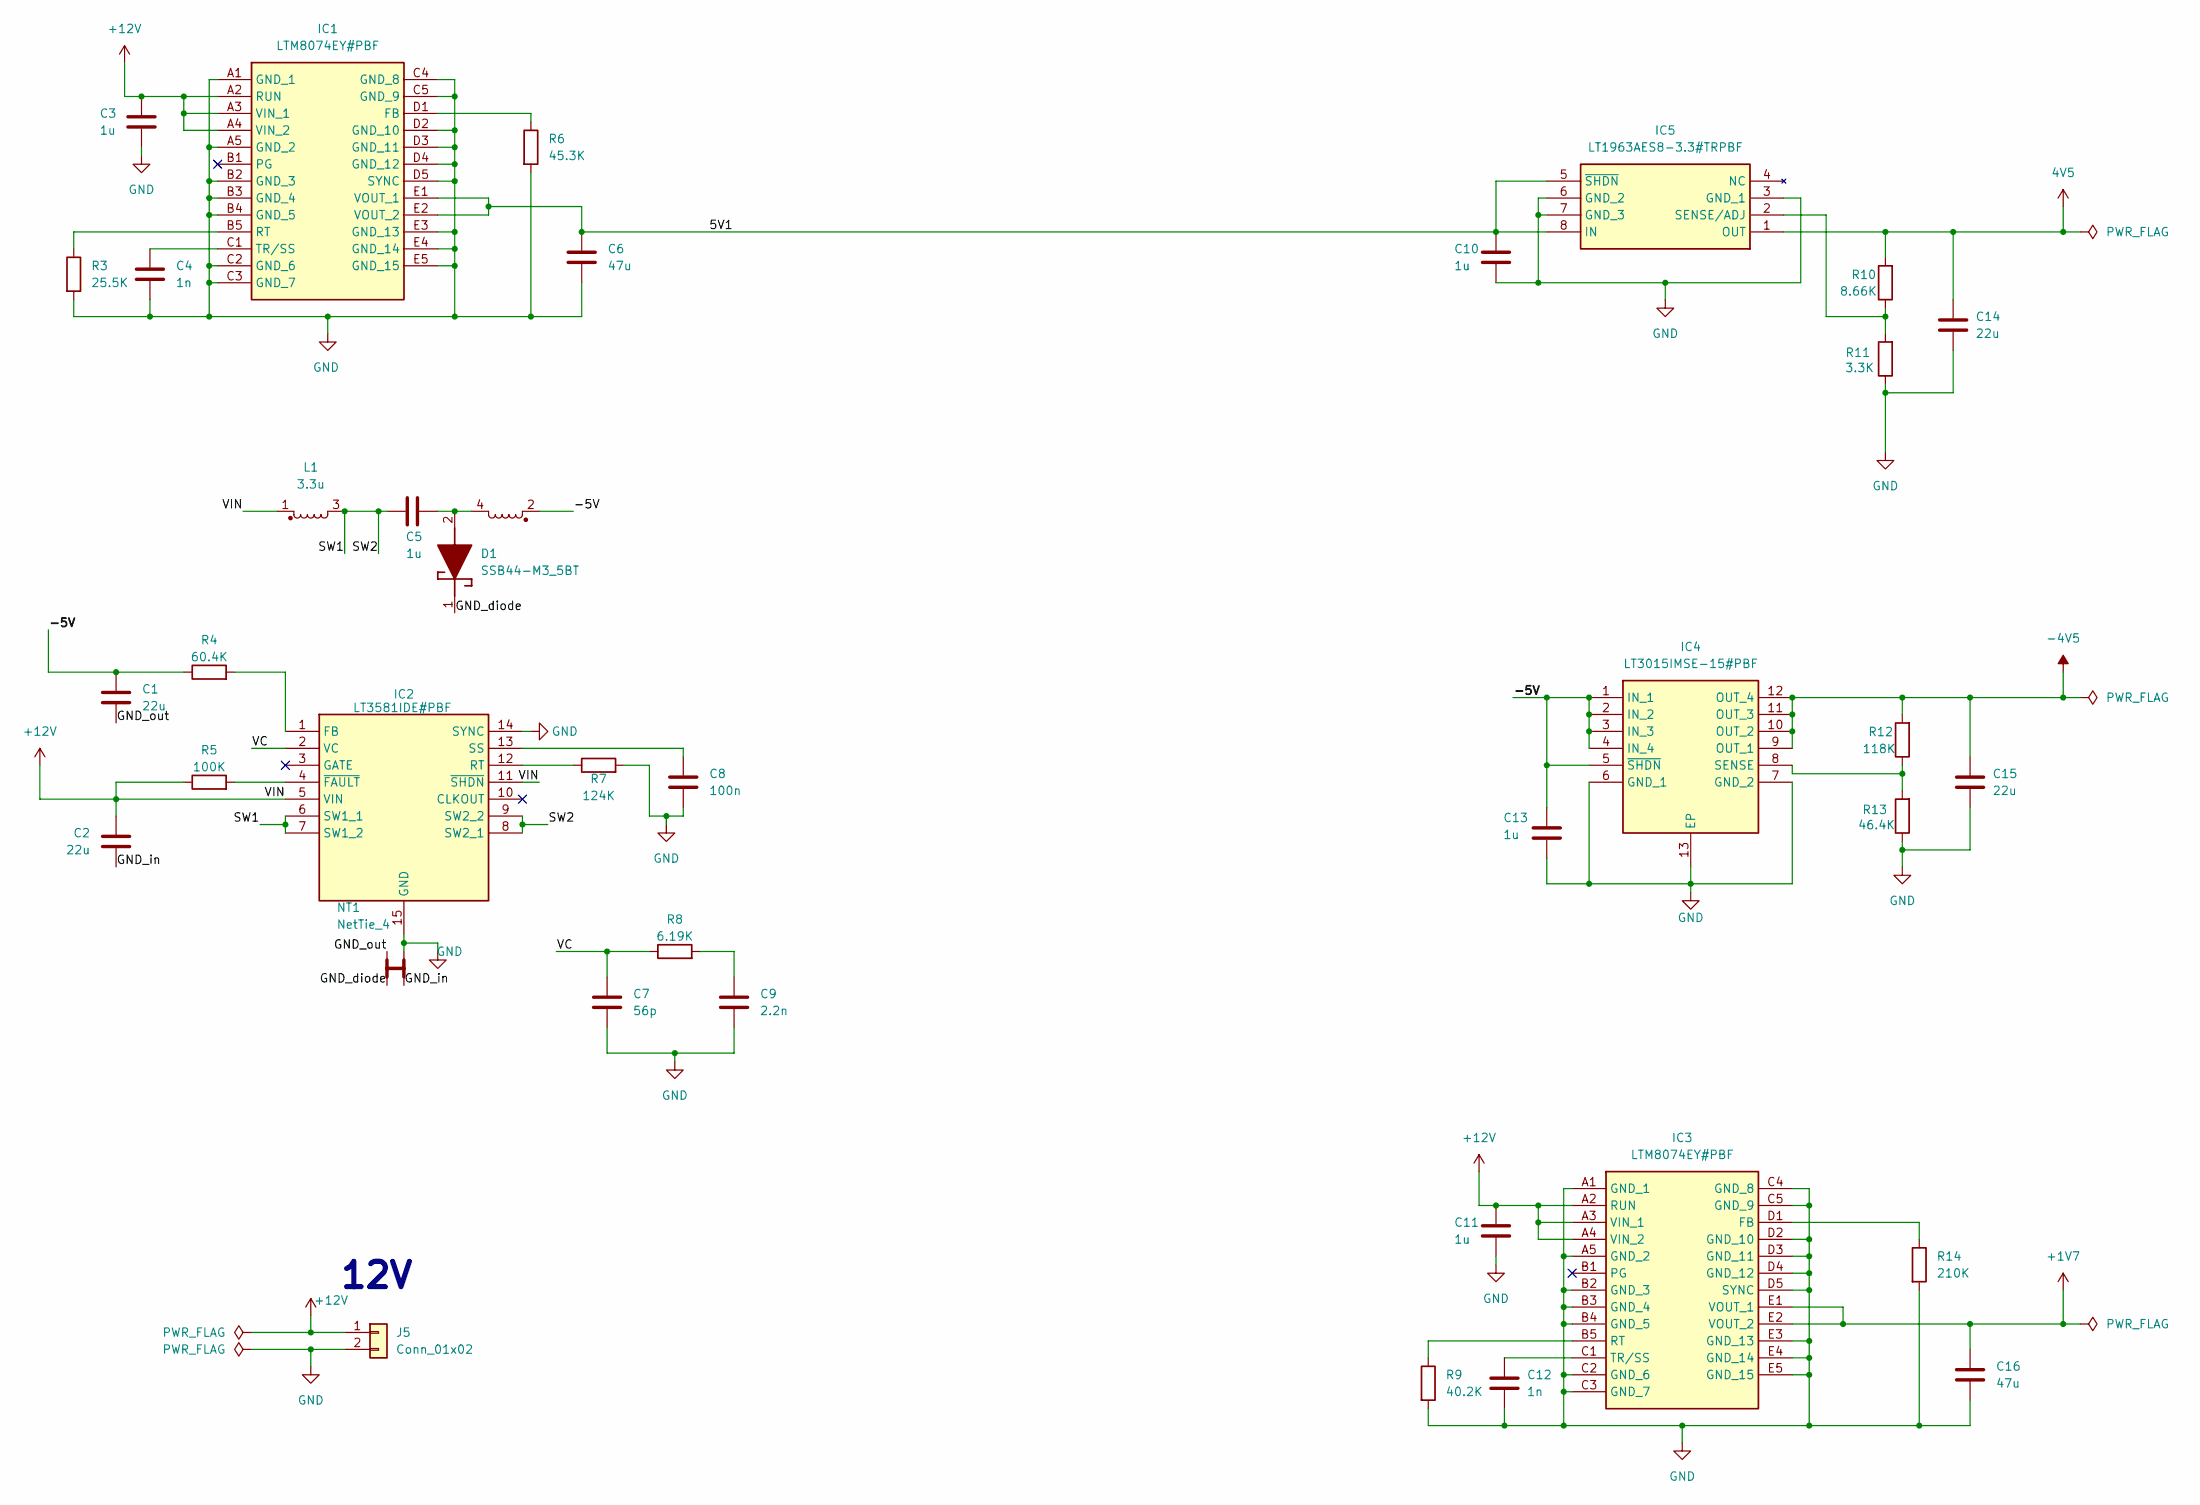
[picture p10: schematic Power Supply.kicad_sch]

Parts:
C1, C2: 22u; C_1210_3225Metric_Pad1.33x2.70mm_HandSolder
C3, C10, C11, C13: 1u; C_0603_1608Metric_Pad1.08x0.95mm_HandSolder
C4, C12: 1n; C_0603_1608Metric_Pad1.08x0.95mm_HandSolder
C5: 1u; C_1206_3216Metric_Pad1.33x1.80mm_HandSolder
C6, C16: 47u; C_0805_2012Metric_Pad1.18x1.45mm_HandSolder
C7: 56p; C_0603_1608Metric_Pad1.08x0.95mm_HandSolder
C8: 100n; C_0603_1608Metric_Pad1.08x0.95mm_HandSolder
C9: 2.2n; C_0603_1608Metric_Pad1.08x0.95mm_HandSolder
C14, C15: 22u; C_0805_2012Metric_Pad1.18x1.45mm_HandSolder
D1: SSB44-M3_5BT; DIOM5436X244N; Mouser Part Number 78-SSB44-M35BT
IC1, IC3: LTM8074EY#PBF; BGA25C65P5X5_400X400X198; Manufacturer_Part_Number LTM8074EY#PBF; Mouser Part Number 584-LTM8074EY#PBF
IC2: LT3581IDE#PBF; SON50P300X400X80-15N-D; Mouser Part Number 584-LT3581IDE#PBF
IC4: LT3015IMSE-15#PBF; SOP65P490X110-13N; Manufacturer_Part_Number LT3015IMSE-15#PBF; Mouser Part Number 584-LT3015IMSE-15PBF
IC5: LT1963AES8-3.3#TRPBF; SOIC127P599X175-8N; Manufacturer_Part_Number LT1963AES8-3.3#TRPBF; Mouser Part Number 584-1963AES8-3.3TPF
J5: Conn_01x02; 1725656
L1: 3.3u; MSD7342332MLC
NT1: NetTie_4; NetTie-4_SMD_Pad0.5mm
R3: 25.5K; R_0603_1608Metric_Pad0.98x0.95mm_HandSolder
R4: 60.4K; R_0603_1608Metric_Pad0.98x0.95mm_HandSolder
R5: 100K; R_0603_1608Metric_Pad0.98x0.95mm_HandSolder
R6: 45.3K; R_0603_1608Metric_Pad0.98x0.95mm_HandSolder
R7: 124K; R_0603_1608Metric_Pad0.98x0.95mm_HandSolder
R8: 6.19K; R_0603_1608Metric_Pad0.98x0.95mm_HandSolder
R9: 40.2K; R_0603_1608Metric_Pad0.98x0.95mm_HandSolder
R10: 8.66K; R_0603_1608Metric_Pad0.98x0.95mm_HandSolder
R11: 3.3K; R_0603_1608Metric_Pad0.98x0.95mm_HandSolder
R12: 118K; R_0603_1608Metric_Pad0.98x0.95mm_HandSolder
R13: 46.4K; R_0603_1608Metric_Pad0.98x0.95mm_HandSolder
R14: 210K; R_0603_1608Metric_Pad0.98x0.95mm_HandSolder

Connections:
4V5: C14.1, IC5.1 (OUT), R10.2; also elsewhere on the board
+1V7: C16.1, IC3.E1 (VOUT_1), IC3.E2 (VOUT_2); also elsewhere on the board
+12V: C2.1, C3.1, C11.1, IC1.A2 (RUN), IC1.A3 (VIN_1), IC1.A4 (VIN_2), IC2.5 (VIN), IC2.11 (~SHDN), IC3.A2 (RUN), IC3.A3 (VIN_1), IC3.A4 (VIN_2), J5.1, L1.1, R5.1
-4V5: C15.1, IC4.9 (OUT_1), IC4.10 (OUT_2), IC4.11 (OUT_3), IC4.12 (OUT_4), R12.2; also elsewhere on the board
/Power Supply/5V1: C6.1, C10.1, IC1.E1 (VOUT_1), IC1.E2 (VOUT_2), IC5.5 (~SHDN), IC5.8 (IN)
/Power Supply/-5V: C1.1, C13.1, IC4.1 (IN_1), IC4.2 (IN_2), IC4.3 (IN_3), IC4.4 (IN_4), IC4.5 (~SHDN), L1.2, R4.1
/Power Supply/GND_diode: D1.1 (K), NT1.1
/Power Supply/GND_in: C2.2, NT1.3
/Power Supply/GND_out: C1.2, NT1.2
/Power Supply/SW1: C5.2, IC2.6 (SW1_1), IC2.7 (SW1_2), IC2.8 (SW2_1), IC2.9 (SW2_2), L1.3
/Power Supply/VC: C7.2, IC2.2 (VC), R8.1
GND: C3.2, C4.2, C6.2, C7.1, C8.2, C9.2, C10.2, C11.2, C12.2, C13.2, C14.2, C15.2, C16.2, IC1.A1 (GND_1), IC1.A5 (GND_2), IC1.B2 (GND_3), IC1.B3 (GND_4), IC1.B4 (GND_5), IC1.C2 (GND_6), IC1.C3 (GND_7), IC1.C4 (GND_8), IC1.C5 (GND_9), IC1.D2 (GND_10), IC1.D3 (GND_11), IC1.D4 (GND_12), IC1.D5 (SYNC), IC1.E3 (GND_13), IC1.E4 (GND_14), IC1.E5 (GND_15), IC2.14 (SYNC), IC2.15 (GND), IC3.A1 (GND_1), IC3.A5 (GND_2), IC3.B2 (GND_3), IC3.B3 (GND_4), IC3.B4 (GND_5), IC3.C2 (GND_6), IC3.C3 (GND_7), IC3.C4 (GND_8), IC3.C5 (GND_9), IC3.D2 (GND_10), IC3.D3 (GND_11), IC3.D4 (GND_12), IC3.D5 (SYNC), IC3.E3 (GND_13), IC3.E4 (GND_14), IC3.E5 (GND_15), IC4.6 (GND_1), IC4.7 (GND_2), IC4.13 (EP), IC5.3 (GND_1), IC5.6 (GND_2), IC5.7 (GND_3), J5.2, NT1.4, R3.2, R6.2, R7.2, R9.2, R11.1, R13.1, R14.2; also elsewhere on the board
unnamed: C9.1, R8.2
unnamed: C5.1, D1.2 (A), L1.4
unnamed: IC1.D1 (FB), R6.1
unnamed: IC1.B5 (RT), R3.1
unnamed: C4.1, IC1.C1 (TR/SS)
unnamed: IC2.1 (FB), R4.2
unnamed: IC2.12 (RT), R7.1
unnamed: C8.1, IC2.13 (SS)
unnamed: IC2.4 (~FAULT), R5.2
unnamed: IC3.D1 (FB), R14.1
unnamed: IC3.B5 (RT), R9.1
unnamed: C12.1, IC3.C1 (TR/SS)
unnamed: IC4.8 (SENSE), R12.1, R13.2
unnamed: IC5.2 (SENSE/ADJ), R10.1, R11.2

Notes on the sheet:
12V

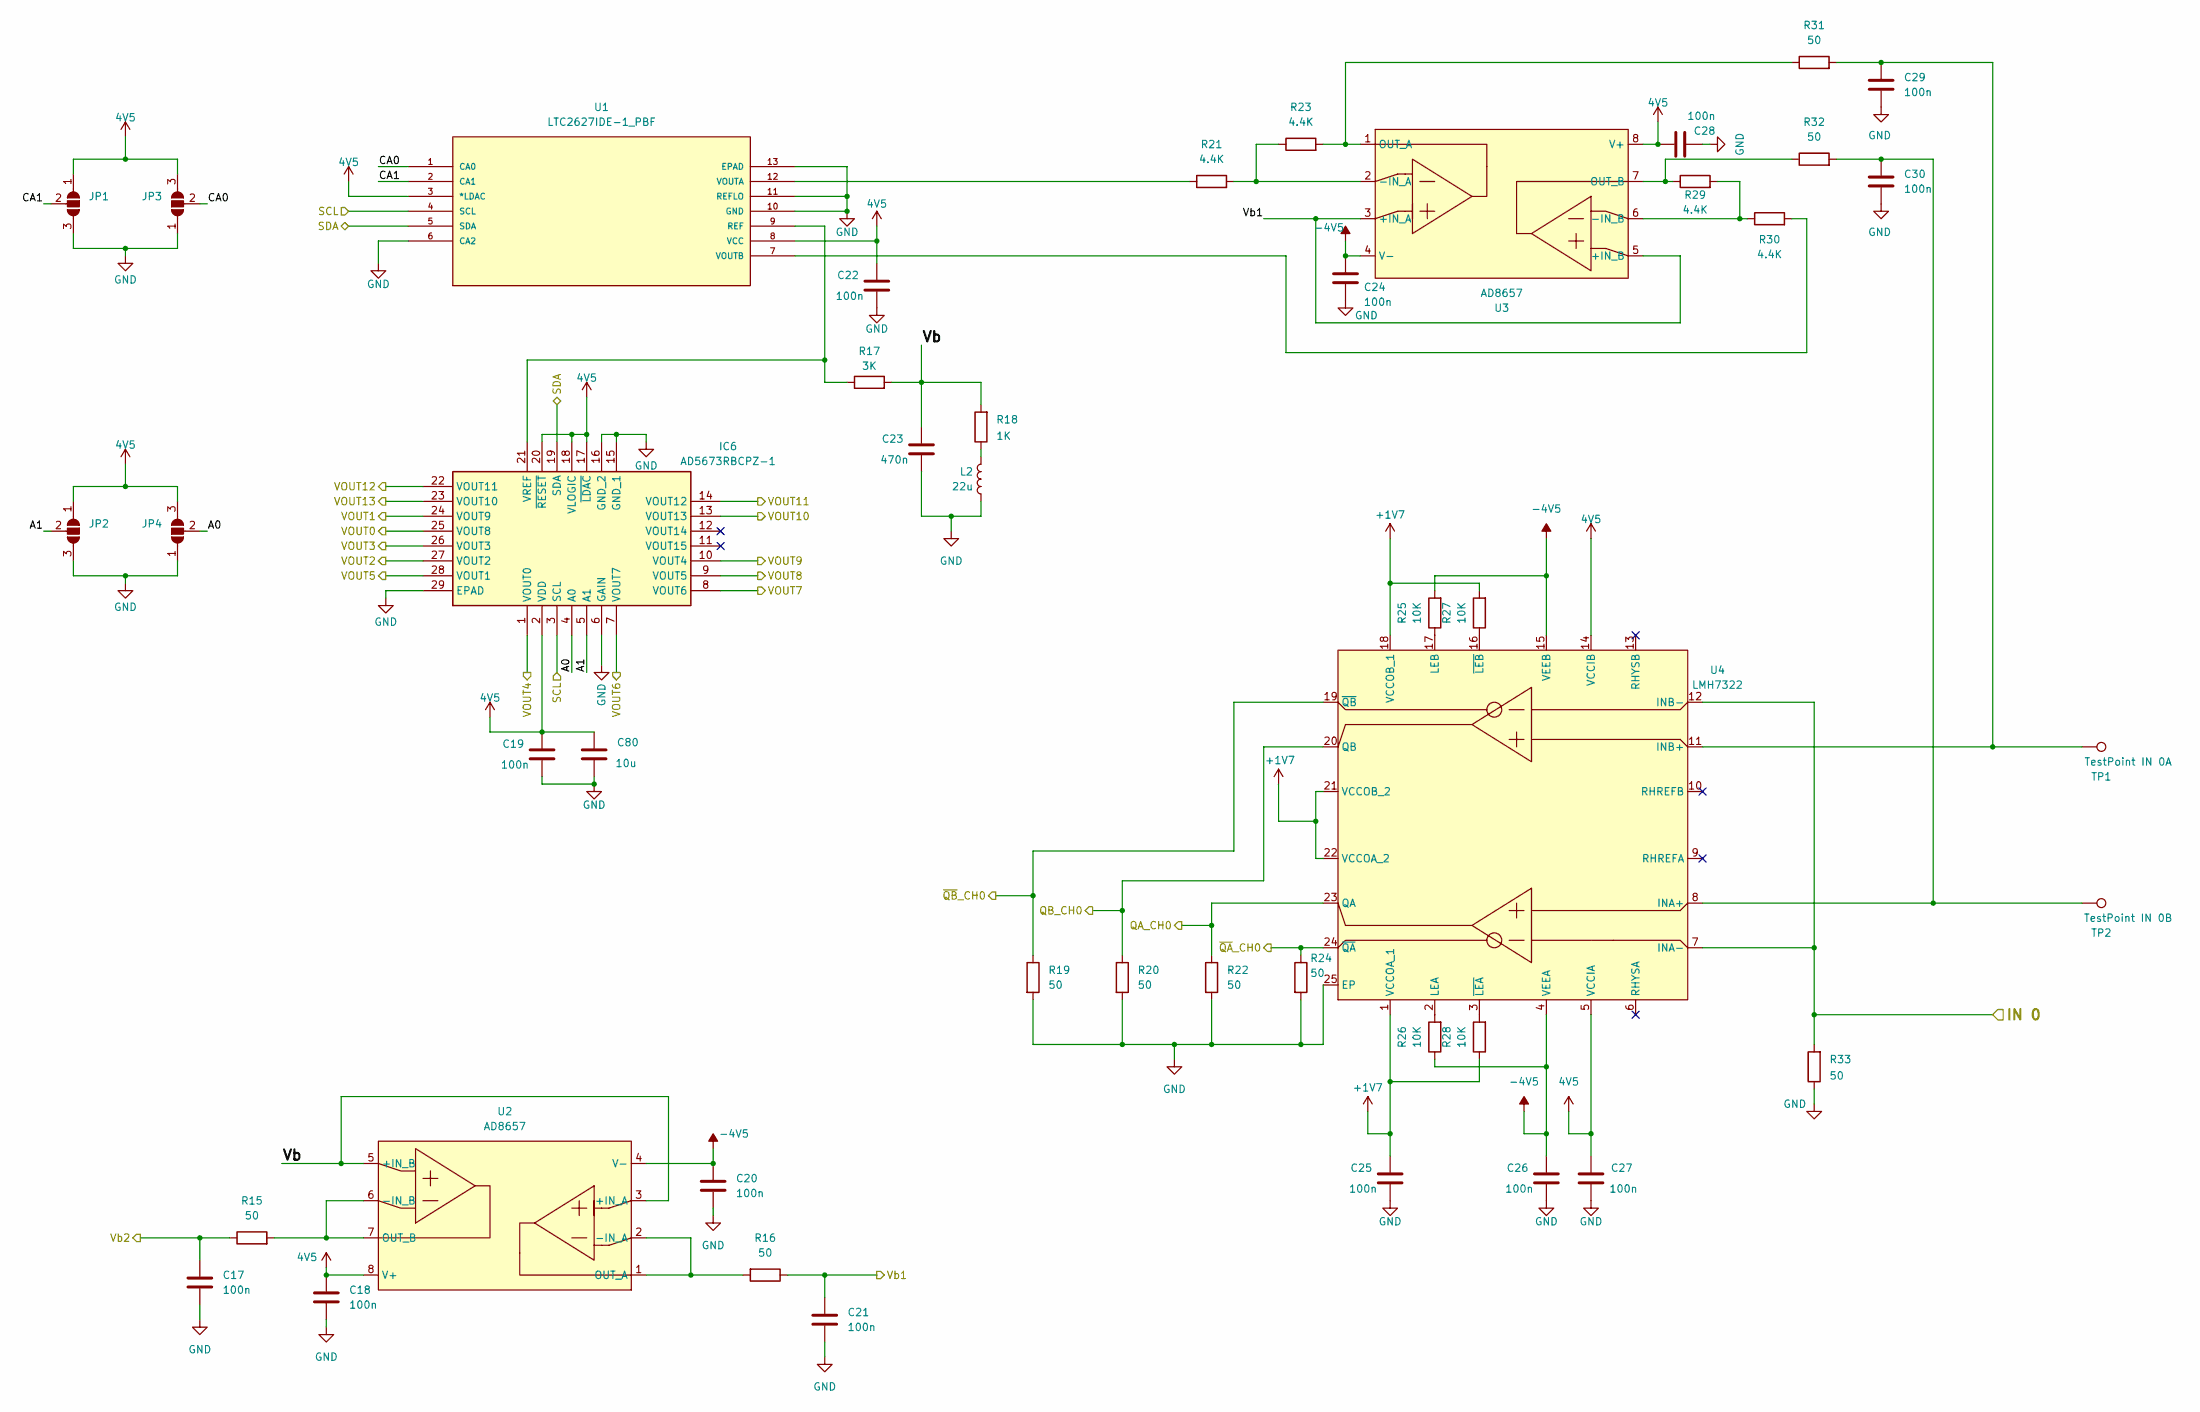
[picture p11: schematic Trigger 0.kicad_sch]

Parts:
C17, C18, C19, C20, C21, C22, C24, C25, C26, C27, C28, C29, C30: 100n; C_0603_1608Metric_Pad1.08x0.95mm_HandSolder
C23: 470n; C_0603_1608Metric_Pad1.08x0.95mm_HandSolder
C80: 10u; C_0603_1608Metric_Pad1.08x0.95mm_HandSolder
IC6: AD5673RBCPZ-1; QFN40P400X400X100-29N-D; Manufacturer_Part_Number AD5673RBCPZ-1; Mouser Part Number 584-AD5673RBCPZ-1
JP1, JP2, JP3, JP4: SolderJumper_3_Open; SolderJumper-3_P1.3mm_Open_RoundedPad1.0x1.5mm_NumberLabels
L2: 22u; L_0603_1608Metric_Pad1.05x0.95mm_HandSolder
R15, R16, R19, R20, R22, R24, R31, R32, R33: 50; R_0603_1608Metric_Pad0.98x0.95mm_HandSolder
R17: 3K; R_0603_1608Metric_Pad0.98x0.95mm_HandSolder
R18: 1K; R_0603_1608Metric_Pad0.98x0.95mm_HandSolder
R21, R23, R29, R30: 4.4K; R_0603_1608Metric_Pad0.98x0.95mm_HandSolder
R25, R26, R27, R28: 10K; R_0603_1608Metric_Pad0.98x0.95mm_HandSolder
TP1: TestPoint IN 0A; TestPoint_Pad_D1.0mm
TP2: TestPoint IN 0B; TestPoint_Pad_D1.0mm
U1: LTC2627IDE-1_PBF; DFN-12_DE; MANUFACTURER_PART_NUMBER ltc2627ide1
U2, U3: AD8657; SOP65P490X110-8N
U4: LMH7322; QFN50P400X400X80-25N

Connections:
4V5: C18.1, C19.1, C22.1, C27.1, C28.1, C80.1, IC6.2 (VDD), IC6.17 (~LDAC), IC6.18 (VLOGIC), IC6.20 (~RESET), JP1.1 (A), JP2.1 (A), JP3.3 (B), JP4.3 (B), U1.3 (*LDAC), U1.8 (VCC), U2.8 (V+), U3.8 (V+), U4.5 (VCCIA), U4.14 (VCCIB); also elsewhere on the board
+1V7: C25.1, R27.2, R28.1, U4.1 (VCCOA_1), U4.18 (VCCOB_1), U4.21 (VCCOB_2), U4.22 (VCCOA_2); also elsewhere on the board
-4V5: C20.1, C24.1, C26.1, R25.2, R26.1, U2.4 (V-), U3.4 (V-), U4.4 (VEEA), U4.15 (VEEB); also elsewhere on the board
/CH0/A0: IC6.4 (A0), JP4.2 (C)
/CH0/A1: IC6.5 (A1), JP2.2 (C)
/CH0/CA0: JP3.2 (C), U1.1 (CA0)
/CH0/CA1: JP1.2 (C), U1.2 (CA1)
/CH0/SCL: IC6.3 (SCL), U1.4 (SCL); also elsewhere on the board
/CH0/SDA: IC6.19 (SDA), U1.5 (SDA); also elsewhere on the board
/CH0/Vb: C23.1, R17.2, R18.2, U2.3 (+IN_A), U2.5 (+IN_B)
/IN 0: R33.2, U4.7 (INA-), U4.12 (INB-); also elsewhere on the board
/QA_CH0: R22.1, U4.23 (QA); also elsewhere on the board
/QB_CH0: R20.1, U4.20 (QB); also elsewhere on the board
/VOUT0: IC6.25 (VOUT8); also elsewhere on the board
/VOUT1: IC6.24 (VOUT9); also elsewhere on the board
/VOUT2: IC6.27 (VOUT2); also elsewhere on the board
/VOUT3: IC6.26 (VOUT3); also elsewhere on the board
/VOUT4: IC6.1 (VOUT0); also elsewhere on the board
/VOUT5: IC6.28 (VOUT1); also elsewhere on the board
/VOUT6: IC6.7 (VOUT7); also elsewhere on the board
/VOUT7: IC6.8 (VOUT6); also elsewhere on the board
/VOUT8: IC6.9 (VOUT5); also elsewhere on the board
/VOUT9: IC6.10 (VOUT4); also elsewhere on the board
/VOUT10: IC6.13 (VOUT13); also elsewhere on the board
/VOUT11: IC6.14 (VOUT12); also elsewhere on the board
/VOUT12: IC6.22 (VOUT11); also elsewhere on the board
/VOUT13: IC6.23 (VOUT10); also elsewhere on the board
/Vb1: C21.1, R16.1, U3.3 (+IN_A), U3.5 (+IN_B); also elsewhere on the board
/Vb2: C17.1, R15.1; also elsewhere on the board
/~QA_CH0: R24.1, U4.24 (~QA); also elsewhere on the board
/~QB_CH0: R19.1, U4.19 (~QB); also elsewhere on the board
GND: C17.2, C18.2, C19.2, C20.2, C21.2, C22.2, C23.2, C24.2, C25.2, C26.2, C27.2, C28.2, C29.2, C30.2, C80.2, IC6.6 (GAIN), IC6.15 (GND_1), IC6.16 (GND_2), IC6.29 (EPAD), JP1.3 (B), JP2.3 (B), JP3.1 (A), JP4.1 (A), L2.2, R19.2, R20.2, R22.2, R24.2, R33.1, U1.6 (CA2), U1.10 (GND), U1.11 (REFLO), U1.13 (EPAD), U4.25 (EP); also elsewhere on the board
unnamed: IC6.21 (VREF), R17.1, U1.9 (REF)
unnamed: L2.1, R18.1
unnamed: R21.1, U1.12 (VOUTA)
unnamed: R30.2, U1.7 (VOUTB)
unnamed: R16.2, U2.1 (OUT_A), U2.2 (-IN_A)
unnamed: R15.2, U2.6 (-IN_B), U2.7 (OUT_B)
unnamed: R21.2, R23.1, U3.2 (-IN_A)
unnamed: R29.2, R30.1, U3.6 (-IN_B)
unnamed: R23.2, R31.1, U3.1 (OUT_A)
unnamed: R29.1, R32.1, U3.7 (OUT_B)
unnamed: C30.1, R32.2, TP2.1, U4.8 (INA+)
unnamed: C29.1, R31.2, TP1.1, U4.11 (INB+)
unnamed: R26.2, U4.2 (LEA)
unnamed: R25.1, U4.17 (LEB)
unnamed: R28.2, U4.3 (~LEA)
unnamed: R27.1, U4.16 (~LEB)

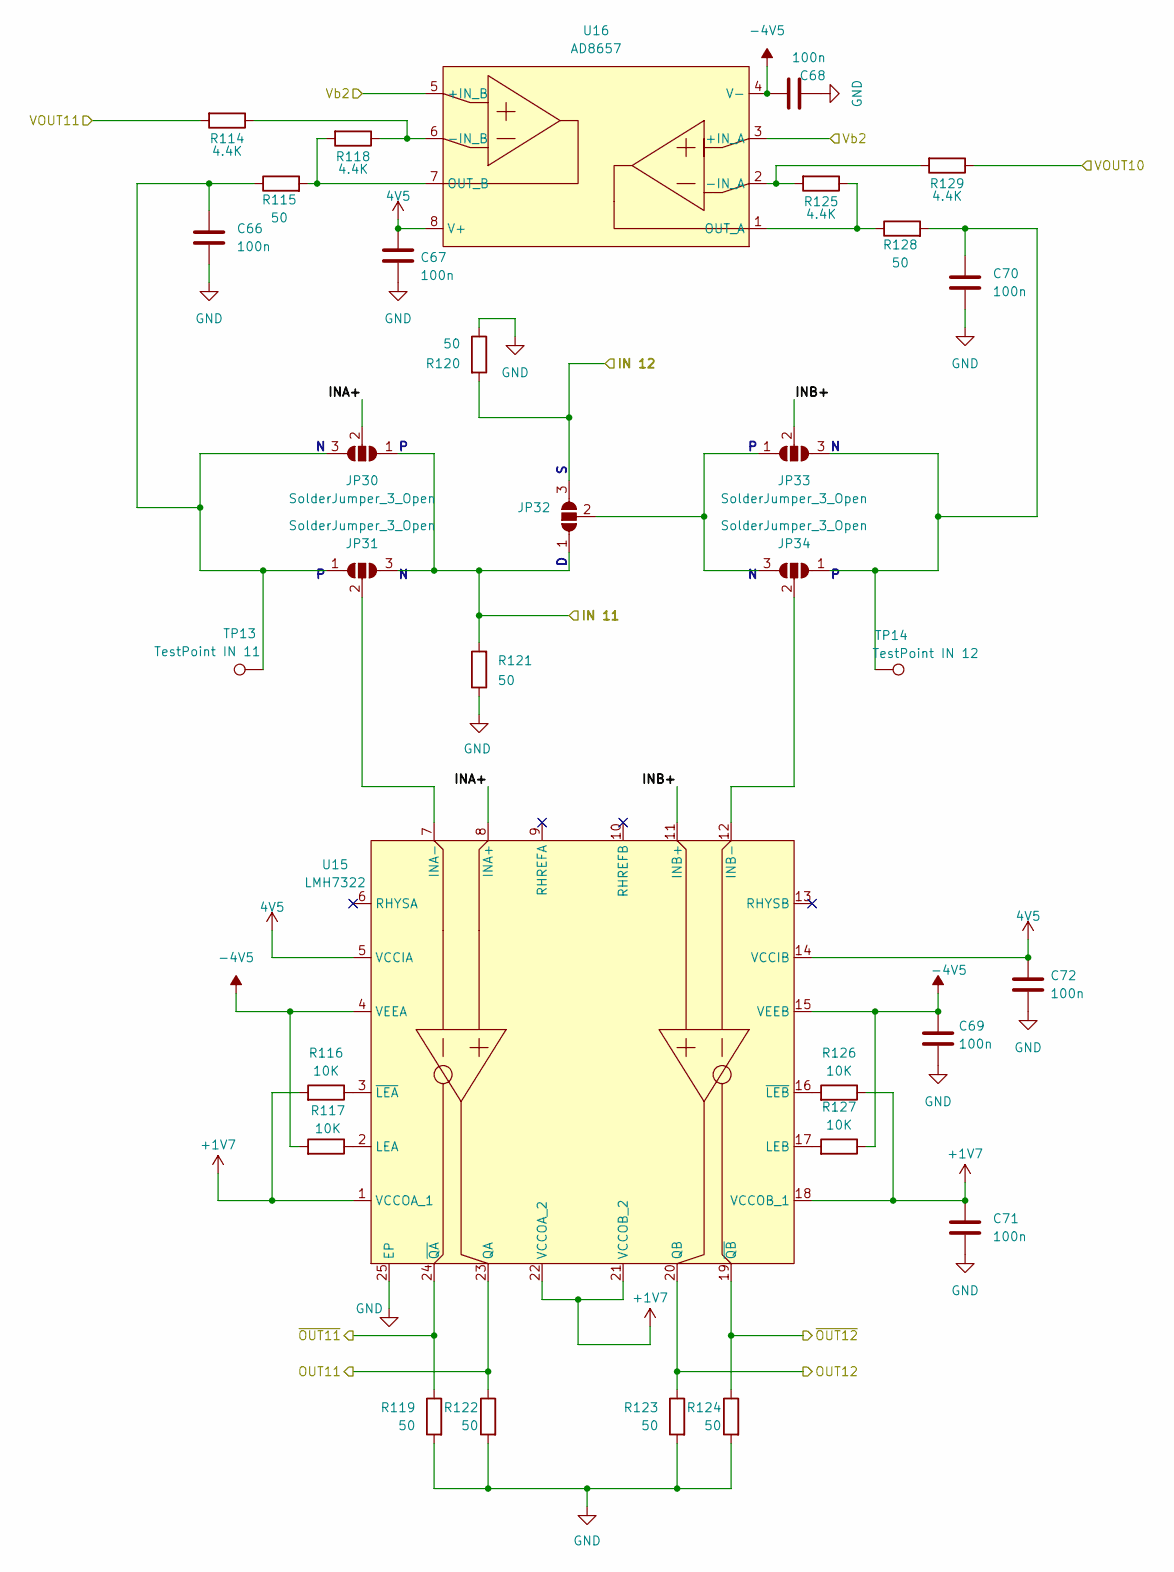
[picture p12: schematic Signals 11-12.kicad_sch]

Parts:
C66, C67, C68, C69, C70, C71, C72: 100n; C_0603_1608Metric_Pad1.08x0.95mm_HandSolder
JP30, JP31, JP32, JP33, JP34: SolderJumper_3_Open; SolderJumper-3_P1.3mm_Open_RoundedPad1.0x1.5mm_NumberLabels
R114, R118, R125, R129: 4.4K; R_0603_1608Metric_Pad0.98x0.95mm_HandSolder
R115, R119, R120, R121, R122, R123, R124, R128: 50; R_0603_1608Metric_Pad0.98x0.95mm_HandSolder
R116, R117, R126, R127: 10K; R_0603_1608Metric_Pad0.98x0.95mm_HandSolder
TP13: TestPoint IN 11; TestPoint_Pad_D1.0mm
TP14: TestPoint IN 12; TestPoint_Pad_D1.0mm
U15: LMH7322; QFN50P400X400X80-25N
U16: AD8657; SOP65P490X110-8N

Connections:
4V5: C67.1, C72.1, U15.5 (VCCIA), U15.14 (VCCIB), U16.8 (V+); also elsewhere on the board
+1V7: C71.1, R116.2, R126.1, U15.1 (VCCOA_1), U15.18 (VCCOB_1), U15.21 (VCCOB_2), U15.22 (VCCOA_2); also elsewhere on the board
-4V5: C68.1, C69.1, R117.2, R127.1, U15.4 (VEEA), U15.15 (VEEB), U16.4 (V-); also elsewhere on the board
/IN 11: JP30.1 (A), JP31.3 (B), JP32.1 (A), R121.2; also elsewhere on the board
/IN 12: JP32.3 (B), R120.2; also elsewhere on the board
/OUT11: R122.1, U15.23 (QA); also elsewhere on the board
/OUT12: R123.1, U15.20 (QB); also elsewhere on the board
/Signals 11-12/INA+: JP30.2 (C), U15.8 (INA+)
/Signals 11-12/INB+: JP33.2 (C), U15.11 (INB+)
/VOUT10: R129.1; also elsewhere on the board
/VOUT11: R114.2; also elsewhere on the board
/Vb2: U16.3 (+IN_A), U16.5 (+IN_B); also elsewhere on the board
/~OUT11: R119.1, U15.24 (~QA); also elsewhere on the board
/~OUT12: R124.1, U15.19 (~QB); also elsewhere on the board
GND: C66.2, C67.2, C68.2, C69.2, C70.2, C71.2, C72.2, R119.2, R120.1, R121.1, R122.2, R123.2, R124.2, U15.25 (EP); also elsewhere on the board
unnamed: C66.1, JP30.3 (B), JP31.1 (A), R115.1, TP13.1
unnamed: JP31.2 (C), U15.7 (INA-)
unnamed: JP32.2 (C), JP33.1 (A), JP34.3 (B)
unnamed: C70.1, JP33.3 (B), JP34.1 (A), R128.2, TP14.1
unnamed: JP34.2 (C), U15.12 (INB-)
unnamed: R117.1, U15.2 (LEA)
unnamed: R127.2, U15.17 (LEB)
unnamed: R116.1, U15.3 (~LEA)
unnamed: R126.2, U15.16 (~LEB)
unnamed: R125.2, R129.2, U16.2 (-IN_A)
unnamed: R114.1, R118.1, U16.6 (-IN_B)
unnamed: R125.1, R128.1, U16.1 (OUT_A)
unnamed: R115.2, R118.2, U16.7 (OUT_B)

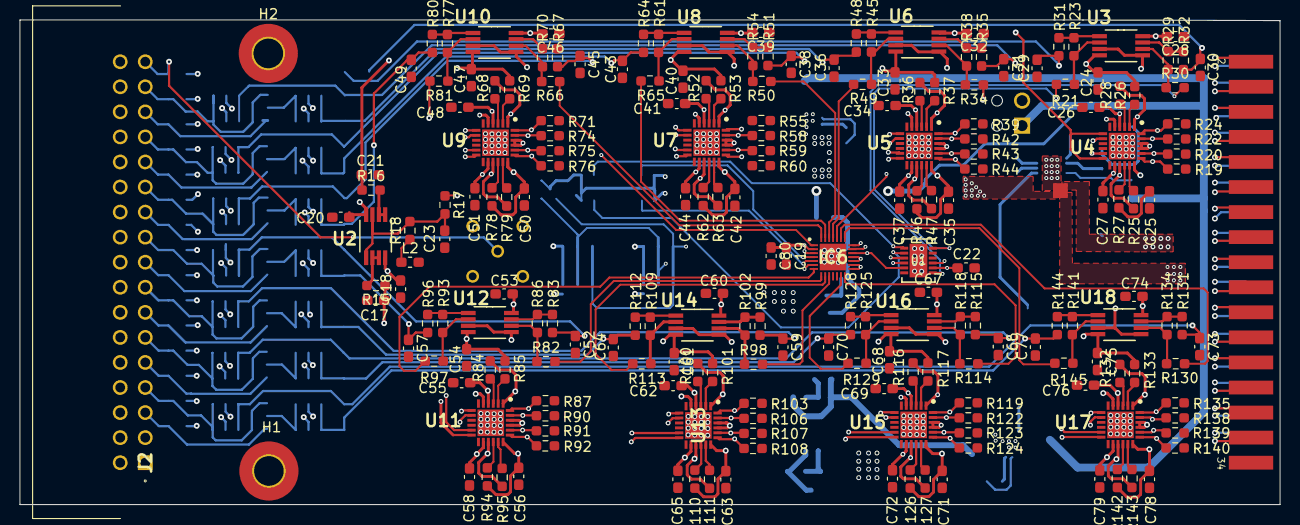
[picture p13: board A5256.kicad_pcb from above]

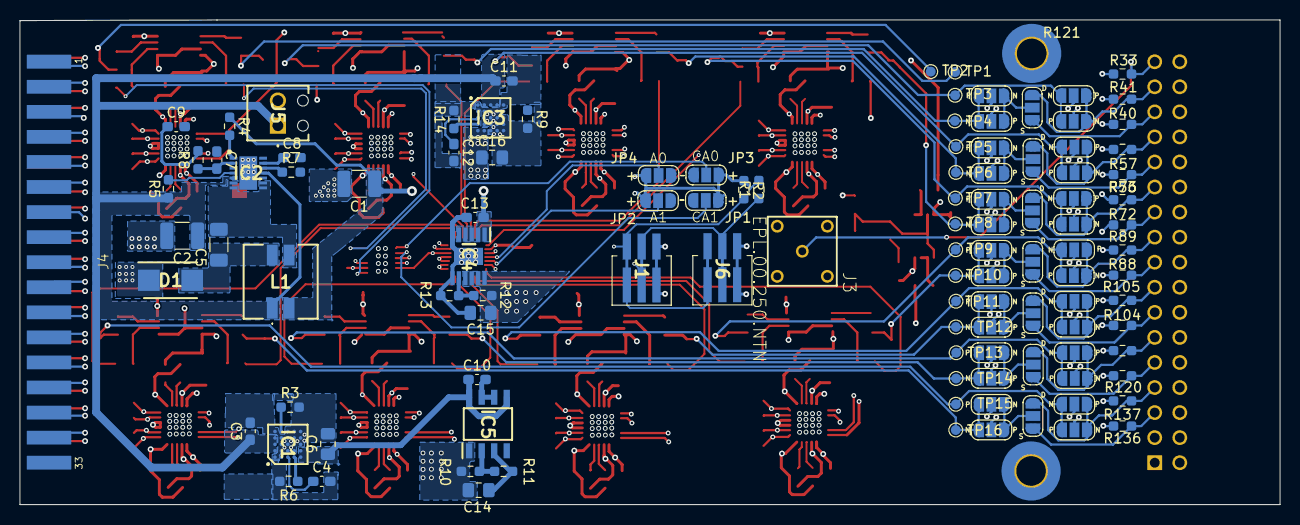
[picture p14: board A5256.kicad_pcb from below]

Board: 6 copper layers, 127.7 x 49.1 mm, 316 parts (112 on the bottom side), 217 nets.
