alexb7396/Tesi_Magistrale/(commit log)

2024-12-16 primo commit tesi
    [A5256.csv, A5256.kicad_pcb, A5256.kicad_sch, Power Supply.kicad_sch, Signal Inputs.kicad_sch, Signals 1-2.kicad_sch, Signals 11-12.kicad_sch, Signals 13-14.kicad_sch]
2024-12-16 quasi terminato il back
    [A5256.kicad_pcb]
2024-12-22 fatto piano di power
    [A5256.kicad_pcb, A5256.kicad_sch, Power Supply.kicad_sch]
2024-12-23 posizionato riferimenti in modo corretto
    [Trigger 0.kicad_sch]
2024-12-28 modifiche per rispettare vincoli azienda
    [A5256-B_Adhesive.gbr, A5256-B_Cu.gbr, A5256-B_Mask.gbr, A5256-B_Paste.gbr, A5256-B_Silkscreen.gbr, A5256-Edge_Cuts.gbr, A5256-F_Adhesive.gbr, A5256-F_Cu.gbr]
2025-01-05 terminato pcb e aggiunto script GUI
    [A5256-B_Adhesive.gbr, A5256-B_Cu.gbr, A5256-B_Mask.gbr, A5256-B_Paste.gbr, A5256-B_Silkscreen.gbr, A5256-Edge_Cuts.gbr, A5256-F_Adhesive.gbr, A5256-F_Cu.gbr]
2025-01-09 completata gui
    [A5256-B_Cu.gbr, A5256-B_Mask.gbr, A5256-B_Paste.gbr, A5256-B_Silkscreen.gbr, A5256-Edge_Cuts.gbr, A5256-F_Cu.gbr, A5256-F_Mask.gbr, A5256-F_Paste.gbr]
2025-02-13 versione finale
    [A5256-all-pos.csv]
2025-02-19 modificato pad esposti
    [A5256-B_Cu.gbr, A5256-B_Mask.gbr, A5256-B_Paste.gbr, A5256-B_Silkscreen.gbr, A5256-Edge_Cuts.gbr, A5256-F_Cu.gbr, A5256-F_Mask.gbr, A5256-F_Paste.gbr]
